madog/planb/README.md

# planb

Electrical and mechanical designs based on the Plan B powder printer (https://ytec3d.com/plan-b/)
