madog/planb/electronics/datasheets/C6602 pinout.txt

1  -> 20V
2  -> N08
3  -> N07
4  -> N06
5  -> N09
6  -> N10
7  -> N11
8  -> N12
9  -> N01
10 -> N02
11 -> N05
12 -> N04
13 -> N03
14 -> 20V
15 -> key
16 -> key
