madog/planb/mechanics/Parts List.xlsx

Sheet: Hardware
Part | PN | Manufacturer | Price | Qty | Subtotal | Ordered?
0.375x1.000 Steel Spring (x12) | 9657K306 | McMaster | $10.35 | 2 | $20.70 | Y
[624ZZ] 4x13 SS Ball Bearing |  | eBay | $0.66 | 25 | $16.48 | Y
[625ZZ] 5x16 SS Ball Bearing |  | eBay | $0.74 | 2 | $1.49 | Y
[LM8UU] 8x24 Linear Bearing | RJ4JP-01-08 | igus (eBay) | $2.29 | 12 | $27.43 | Y
M3 SS Nut (x100) | 91828A211 | McMaster | $5.55 | 1 | $5.55 | Y
M3 SS Washer (x100) | 93475A210 | McMaster | $1.62 | 2 | $3.24 | Y
M3x10 SS SHCS (x100) | 91292A113 | McMaster | $4.53 | 1 | $4.53 | Y
M3x12 SS Standoff | 93655A422 | McMaster | $4.03 | 4 | $16.12 | Y
M3x16 SS SHCS (x100) | 91292A115 | McMaster | $5.36 | 1 | $5.36 | Y
M4 SS Locknut (x100) | 93625A150 | McMaster | $5.62 | 3 | $16.86 | Y
M4 SS Nut (x100) | 91828A231 | McMaster | $6.45 | 1 | $6.45 | Y
M4 SS Washer (x100) | 93475A230 | McMaster | $1.86 | 5 | $9.30 | Y
M4x10 SS SHCS (x100) | 91292A116 | McMaster | $6.59 | 1 | $6.59 | Y
M4x12 SS SHCS (x100) | 91292A117 | McMaster | $6.59 | 1 | $6.59 | Y
M4x16 SS SHCS (x100) | 91292A118 | McMaster | $7.42 | 1 | $7.42 | Y
M4x20 SS SHCS (x100) | 91292A121 | McMaster | $8.42 | 1 | $8.42 | Y
M4x25 SS SHCS (x100) | 91292A122 | McMaster | $9.06 | 1 | $9.06 | Y
M4x25 SS Standoff FF | 94868A045 | McMaster | $4.39 | 8 | $35.12 | Y
M4x30 SS SHCS (x100) | 91292A130 | McMaster | $10.30 | 1 | $10.30 | Y
M4x30 SS Standoff FF | 94868A183 | McMaster | $3.26 | 4 | $13.04 | Y
M4x35 SS SHCS (x50) | 91292A131 | McMaster | $6.80 | 1 | $6.80 | Y
M4x40 SS FHSS (x50) | 92125A205 | McMaster | $9.60 | 1 | $9.60 | Y
M4x40 SS SHCS (x50) | 91292A132 | McMaster | $6.44 | 1 | $6.44 | Y
M4x50 SS SHCS (x25) | 91292A140 | McMaster | $5.46 | 1 | $5.46 | Y
M5 SS Fender Washer (x100) | 91116A140 | McMaster | $7.04 | 1 | $7.04 | Y
M6 SS Nut (x100) | 91828A251 | McMaster | $8.73 | 1 | $8.73 | Y
M6 SS Washer (x100) | 93475A250 | McMaster | $4.86 | 1 | $4.86 | Y
M8 SS Nut (x50) | 91828A410 | McMaster | $9.98 | 1 | $9.98 | Y
M4x500 SS Threaded Rod | 90024A222 | McMaster | $4.20 | 1 | $4.20 | Y
M6x200 SS Threaded Rod | 93805A640 | McMaster | $4.00 | 6 | $24.00 | Y
M8x150 SS Threaded Rod | 93805A641 | McMaster | $5.03 | 3 | $15.09 | Y
5x200 SS Rotary Shaft | 1265K44 | McMaster | $16.96 | 1 | $16.96 | Y
5x400 SS Rotary Shaft | 1265K46 | McMaster | $29.83 | 1 | $29.83 | Y
8x1000 SS Linear Shaft | 6459K115 | eBay | $18.00 | 4 | $72.00 | Y
16x500 2mm Wall SS Tube | 50365K35 | McMaster | $55.02 | 1 | $55.02 | Y
5mm shaft coupler |  | Amazon | $3.48 | 2 | $6.97 | Y
 |  |  |  | Total: | $506.05

Sheet: 3DP
Part Name | Qty | Volume (cm^3) | Volume subtotal | Material/Process | Rec'd?
Carriage Belt Clamp | 2 | 14.804 | 29.608 | ASA/FDM | Yes
Carriage Carrier | 1 | 24.798 | 24.798 | ASA/FDM | Yes
Carriage Cartridge Adapter | 1 | 1.369 | 1.369 | ASA/FDM | Yes
GUI Button | 8 | 0.381 | 3.048 | Nylon/SLS | Yes
GUI Corner Holder | 2 | 13.702 | 27.404 | Nylon/SLS | Yes
GUI Face | 1 | 88.796 | 88.796 | Nylon/SLS | Yes
GUI Rotary | 1 | 3.641 | 3.641 | Nylon/SLS | Yes
Hopper Idler | 1 | 28.926 | 28.926 | ASA/FDM | Yes
Hopper Idler (mirrored) | 1 | 28.926 | 28.926 | ASA/FDM | Yes
Hopper Linear Bearing Holder | 6 | 30.644 | 183.864 | ASA/FDM | Yes
Hopper Motor Holder | 1 | 40.381 | 40.381 | ASA/FDM | Yes
Hopper Nut Trap | 3 | 9.951 | 29.853 | ASA/FDM | Yes
Hopper Nut Trap Holder | 3 | 3.947 | 11.841 | ASA/FDM | Yes
Hopper Rod Clamp | 1 | 34.831 | 34.831 | ASA/FDM | Yes
Hopper Smooth Rod Clamp | 12 | 1.748 | 20.976 | ASA/FDM | Yes
Piston Driver Clamp | 6 | 4.301 | 25.806 | ASA/FDM | Yes
Piston Flag | 3 | 0.246 | 0.738 | Nylon/SLS | Yes
Piston Flag Holder | 3 | 1.861 | 5.583 | ASA/FDM | Yes
Piston Guide Holder | 12 | 11.831 | 141.972 | ASA/FDM | Yes
Piston Nut Trap | 12 | 0.577 | 6.924 | ASA/FDM | Yes
Piston Wall Guide | 6 | 7.048 | 42.288 | ASA/FDM | Yes
Piston Wall Guide Small | 4 | 1.713 | 6.852 | ASA/FDM | Yes
Piston Wall Guide Wide | 4 | 3.694 | 14.776 | ASA/FDM | Yes
Spreader Belt Clamp | 2 | 1.113 | 2.226 | ASA/FDM | Yes
Spreader Flag | 1 | 0.550 | 0.55 | Nylon/SLS | Yes
Spreader Frame | 2 | 9.221 | 18.442 | ASA/FDM | Yes
Spreader Holder | 2 | 2.815 | 5.63 | ASA/FDM | Yes
Spreader Linear Bearing Clamp | 2 | 11.361 | 22.722 | ASA/FDM | Yes
X-axis Driver Holder | 1 | 22.917 | 22.917 | ASA/FDM | Yes
X-axis Holder Coupler | 8 | 4.175 | 33.4 | ASA/FDM | Yes
X-axis Idler | 2 | 10.207 | 20.414 | ASA/FDM | Yes
X-axis Motor Holder | 1 | 25.435 | 25.435 | ASA/FDM | Yes
X-axis Rod Holder | 6 | 1.668 | 10.008 | ASA/FDM | Yes
X-axis Y Idler | 1 | 6.938 | 6.938 | ASA/FDM | Yes
X-axis Y Motor Holder | 1 | 11.888 | 11.888 | ASA/FDM | Yes
Y-axis Belt Clamp | 4 | 0.797 | 3.188 | ASA/FDM | Yes
Y-axis Belt Idler 1 | 1 | 4.276 | 4.276 | ASA/FDM | No
Y-axis Belt Idler 2 | 1 | 4.276 | 4.276 | ASA/FDM | No
Y-axis Belt Return | 1 | 3.812 | 3.812 | ASA/FDM | Yes
Y-axis Carriage Flag | 1 | 0.670 | 0.67 | Nylon/SLS | Yes
Y-axis Frame Block | 2 | 30.438 | 60.876 | ASA/FDM | Yes
Y-axis Linear Bearing Clamp | 2 | 2.401 | 4.802 | ASA/FDM | Yes
Y-axis X-axis flag | 1 | 0.802 | 0.802 | Nylon/SLS | Yes
Totals | 136 |  | 1066.473
