madog/planb/electronics/bom/master_v1.xlsx

Mouser P/N | Description | Price | Qty | Subtotal | Board Qtys
80-C1206C475K3R | Multilayer Ceramic Capacitors MLCC - SMD/SMT 25volts 4.7uF X7R 10% | $0.34 | 10 | $3.40 | BD | 5
80-C1206C106K3R | Multilayer Ceramic Capacitors MLCC - SMD/SMT 10uF 25 Volts 10% X7R | $0.69 | 10 | $6.90 | FFC | 5
80-C1206C105K3R | Multilayer Ceramic Capacitors MLCC - SMD/SMT 25volts 1uF X7R 10% | $0.22 | 5 | $1.10
80-C1206C104K3R | Multilayer Ceramic Capacitors MLCC - SMD/SMT 25volts 0.1uF X7R 10% | $0.12 | 15 | $1.80 | Total | $104.99
80-C1206C103K3R | Multilayer Ceramic Capacitors MLCC - SMD/SMT 25volts 10000pF X7R 10% | $0.28 | 5 | $1.40
80-C1206C223K3R | Multilayer Ceramic Capacitors MLCC - SMD/SMT 25volts 22000pF X7R 10% | $0.32 | 5 | $1.60
80-C0805C182K5R | Multilayer Ceramic Capacitors MLCC - SMD/SMT 50volts 1800pF X7R 10% | $0.23 | 5 | $1.15
80-C0805C273K5R | Multilayer Ceramic Capacitors MLCC - SMD/SMT 50volts 27000pF X7R 10% | $0.11 | 5 | $0.55
512-FSV8100V | Schottky Diodes & Rectifiers 8 Amp 100V Schottky Rectifier | $0.63 | 10 | $6.30
604-WP1543SGC | Standard LEDs - Through Hole GREEN WATER CLEAR | $0.21 | 15 | $3.15
604-WP1543SRC/C | Standard LEDs - Through Hole RED WATER CLEAR | $0.31 | 5 | $1.55
81-FDVE1040-H-4R7MP3 | Fixed Inductors 4.7uH 13.8mOhms 8.2A +/-20% | $1.52 | 5 | $7.60
512-FDD4141 | MOSFET -40V P-Channel PowerTrench | $1.05 | 5 | $5.25
71-CRCW1206-47K-E3 | Thick Film Resistors 1/4watt 47Kohms 1% | $0.10 | 5 | $0.50
71-CRCW1206J-1K-E3 | Thick Film Resistors 1/4watt 1Kohms 5% | $0.02 | 20 | $0.44
71-CRCW120610K0JNEB | Thick Film Resistors - SMD 1/4watt 10Kohms 5% | $0.10 | 10 | $1.00
71-CRCW1206470RJNEB | Thick Film Resistors 1/4watt 470ohms 5% | $0.10 | 5 | $0.50
71-CRCW0805-1.37K-E3 | Thick Film Resistors 1/8watt 1.37Kohms 1% 100ppm | $0.10 | 5 | $0.50
71-CRCW0805154KFKEA | Thick Film Resistors 1/8watt 154Kohms 1% 100ppm | $0.10 | 5 | $0.50
71-CRCW080510K0DHEAP | Thick Film Resistors 1/8W 10kOhm .5% | $0.27 | 5 | $1.35
595-TPS55330RTER | Switching Voltage Regulators 5A 24V Wide In Range DC-DC Reg | $3.09 | 5 | $15.45
595-CD74HC4067M96 | Multiplexer Switch ICs Hi-Spd CMOS 16Ch Anl Mltplxr/Demltplxr | $0.78 | 5 | $3.90
595-ULN2803ADWR | Darlington Transistors TRANSISTOR ARRAYS | $1.41 | 10 | $14.10
630-ACPL-217-50BE | Transistor Output Optocouplers 3000Vrms 50% CTR | $0.60 | 5 | $3.00
571-282834-2 | Fixed Terminal Blocks 2P SIDE ENTRY 2.54mm | $0.52 | 5 | $2.60
649-68015-402HLF | Headers & Wire Housings 2P SR UNSHRD HRD TIN OVER NI | $0.18 | 5 | $0.90
538-90121-0763 | Headers & Wire Housings 2.54MM CGRIDIII HDR 3P R/A SR SEL AU | $0.75 | 10 | $7.50
649-68021-408HLF | Headers & Wire Housings 8P SR UNSHRD HRD TIN OVER NI | $0.47 | 5 | $2.35
649-77313-418-16LF | Headers & Wire Housings 16P STR DR TMT HDR TIN .45IN LENGTH | $0.50 | 10 | $5.00
649-SFW16R-2STE1LF | FFC & FPC Connectors 16P SIDE SMT ZIF UPPER CONTACT | $0.73 | 5 | $3.65
