madog/planb/mechanics/Electronics/Omron PEC12R-4x20F-Xxxxx.stp

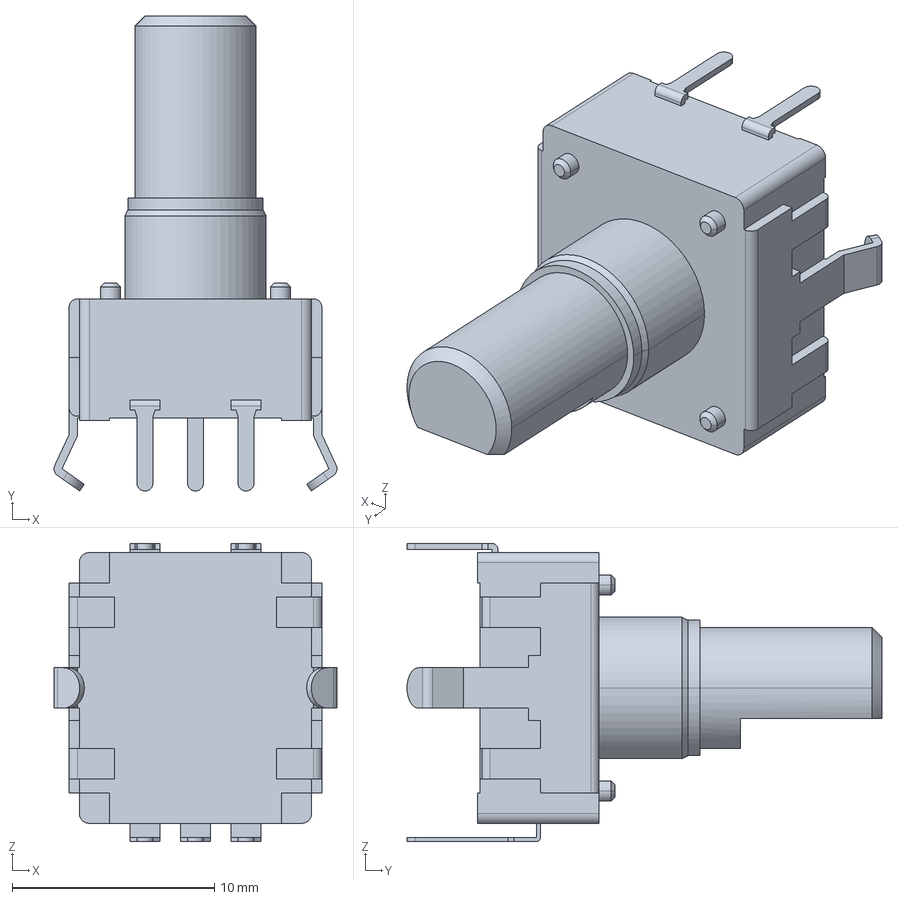
[picture p1: CAD file, 2018-04-14]
mechanics/Electronics/Omron PEC12R-4x20F-Xxxxx.stp
14.0 x 23.5 x 14.7 mm
