madog/planb/mechanics/STLs/Y-axis Belt Idler.stl

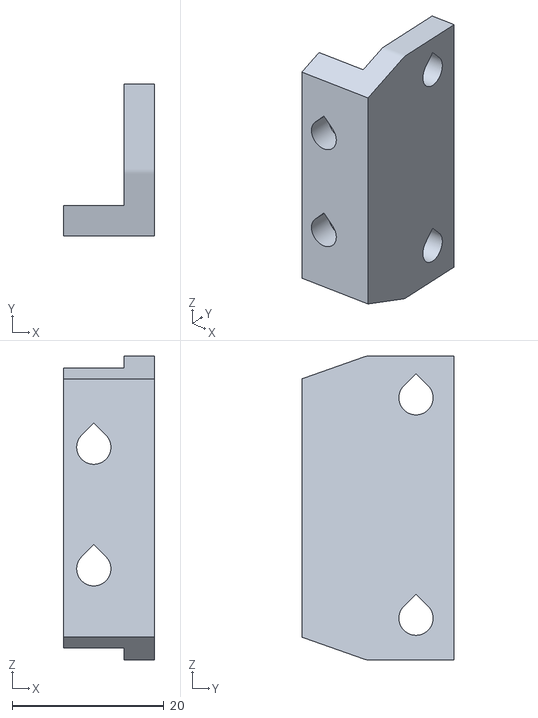
[picture p2: CAD file, 2017-12-08]
mechanics/STLs/Y-axis Belt Idler.stl
12.0 x 20.0 x 40.0
