madog/planb/mechanics/Electronics/NHD-0420CW.stp

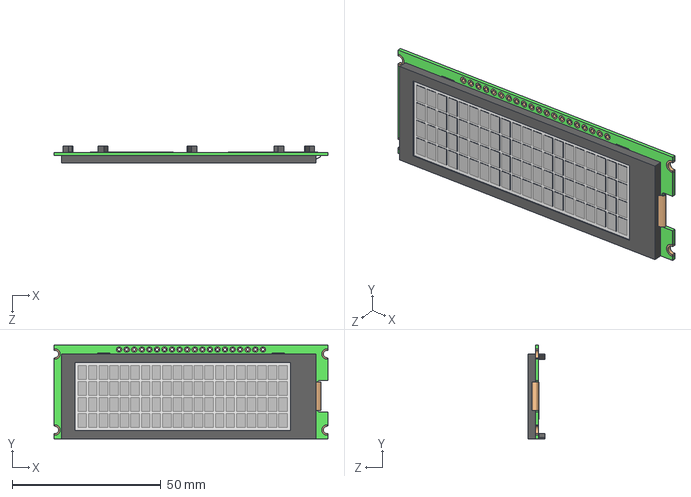
[picture p3: CAD file, 2018-04-14]
mechanics/Electronics/NHD-0420CW.stp
92.0 x 31.5 x 5.60 mm
