madog/planb/mechanics/STLs/Spreader Holder.stl

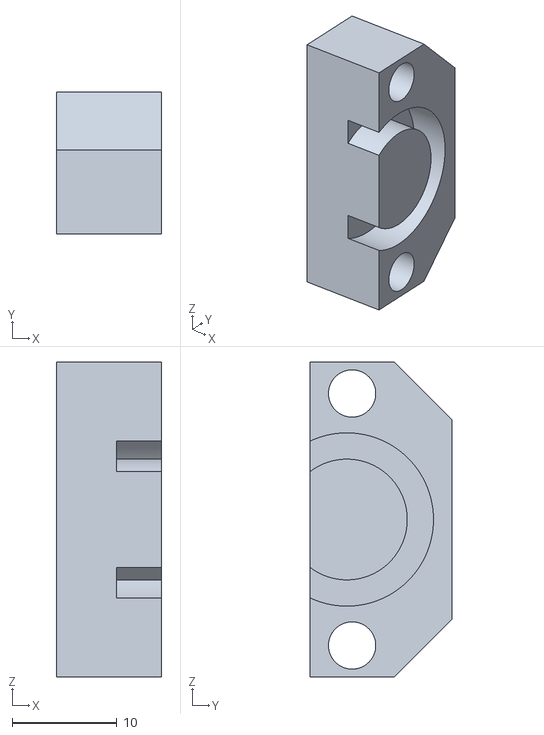
[picture p4: CAD file, 2017-12-08]
mechanics/STLs/Spreader Holder.stl
10.0 x 13.5 x 30.0
