madog/planb/mechanics/STLs/Carriage Belt Clamp.stl

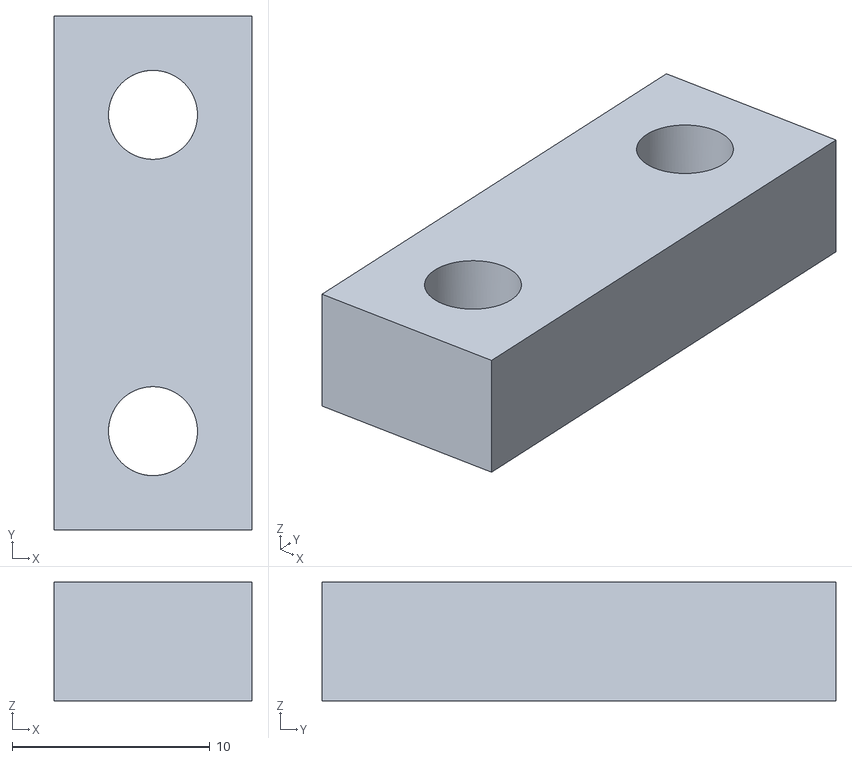
[picture p5: CAD file, 2017-10-05]
mechanics/STLs/Carriage Belt Clamp.stl
10.0 x 26.0 x 6.00
