madog/planb/mechanics/STLs/Y-axis Belt Clamp.stl

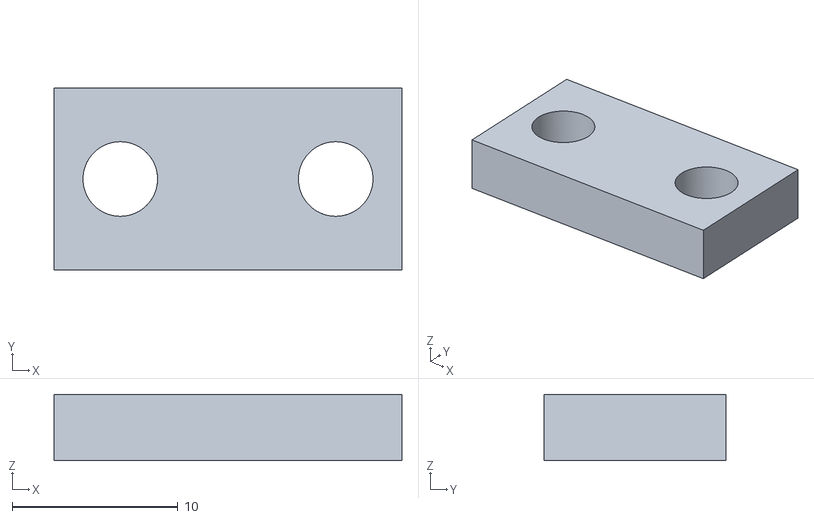
[picture p6: CAD file, 2017-10-05]
mechanics/STLs/Y-axis Belt Clamp.stl
21.0 x 11.0 x 4.00
