madog/planb/mechanics/STLs/Y-axis X-axis Flag.stl

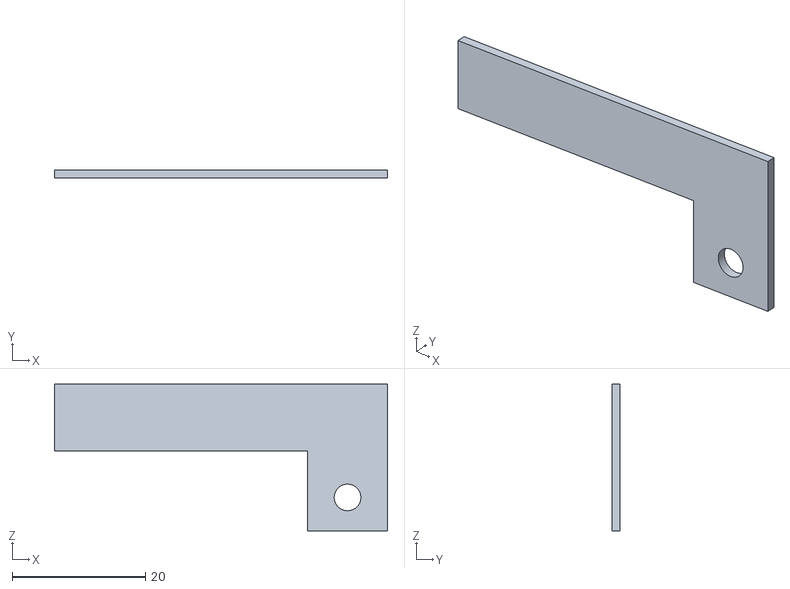
[picture p7: CAD file, 2017-10-05]
mechanics/STLs/Y-axis X-axis Flag.stl
50.0 x 1.27 x 22.0
