madog/planb/mechanics/STLs/Piston Guide Holder.stl

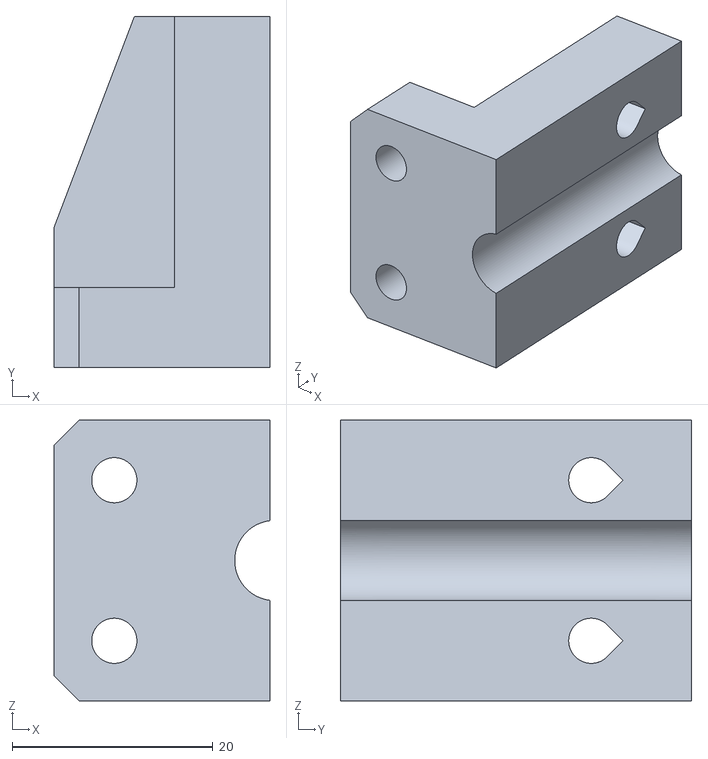
[picture p8: CAD file, 2017-10-05]
mechanics/STLs/Piston Guide Holder.stl
21.5 x 35.0 x 28.0
