madog/planb/mechanics/STLs/Spreader Belt Clamp.stl

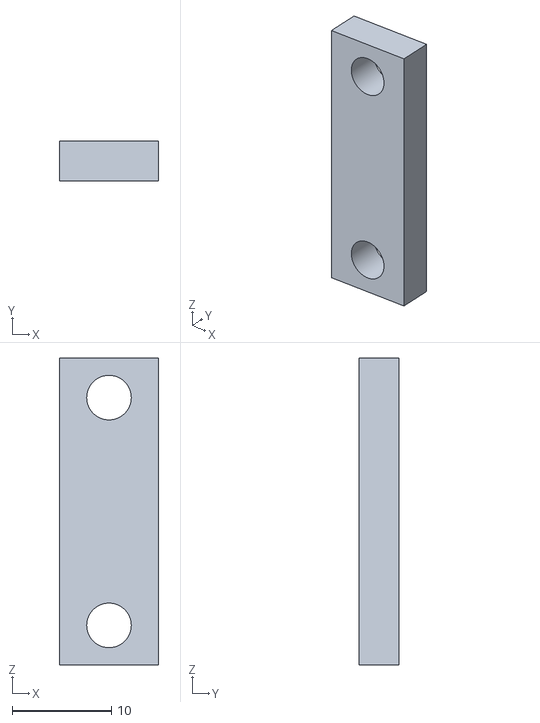
[picture p9: CAD file, 2017-10-05]
mechanics/STLs/Spreader Belt Clamp.stl
10.0 x 4.00 x 31.0
