madog/planb/mechanics/STLs/Spreader Frame.stl

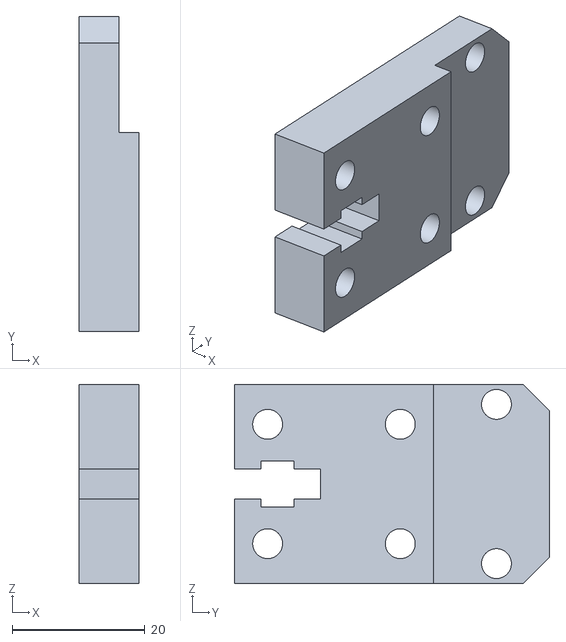
[picture p10: CAD file, 2017-10-05]
mechanics/STLs/Spreader Frame.stl
9.00 x 47.5 x 30.0
