madog/planb/mechanics/STLs/Hopper Idler.stl

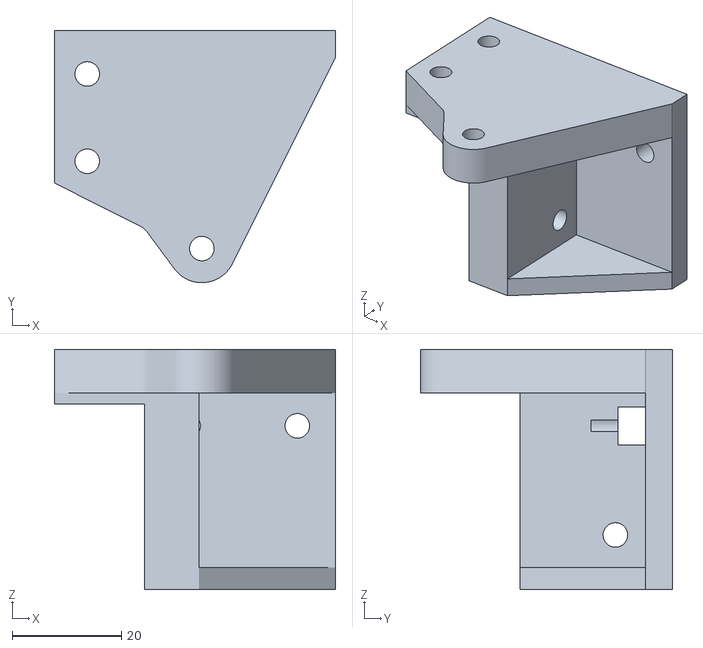
[picture p11: CAD file, 2017-10-05]
mechanics/STLs/Hopper Idler.stl
51.5 x 46.2 x 44.0
