madog/planb/mechanics/STLs/Piston Wall Guide.stl

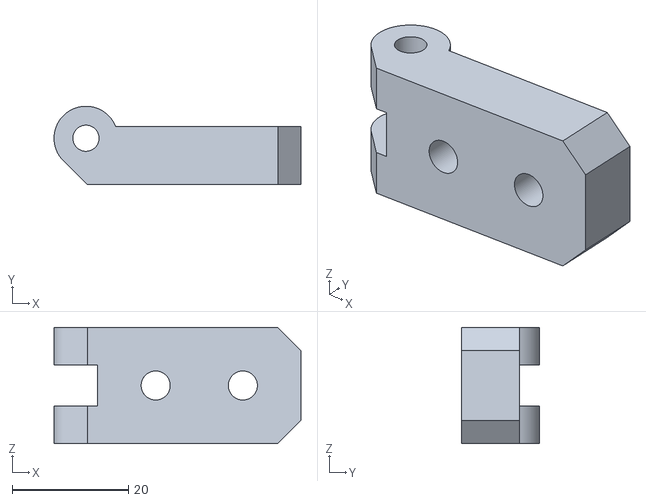
[picture p12: CAD file, 2017-10-05]
mechanics/STLs/Piston Wall Guide.stl
42.5 x 13.5 x 20.0
