madog/planb/mechanics/STLs/X-axis Y Motor Holder.stl

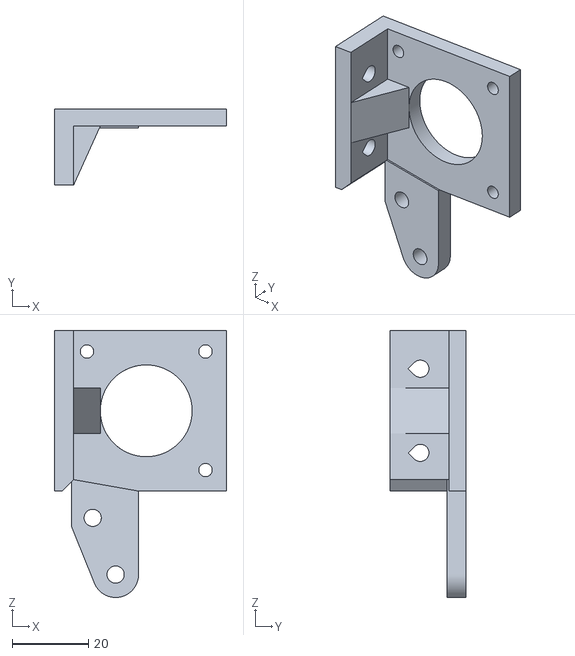
[picture p13: CAD file, 2017-10-05]
mechanics/STLs/X-axis Y Motor Holder.stl
45.0 x 20.0 x 69.8
