madog/planb/mechanics/STLs/GUI Corner Holder.stl

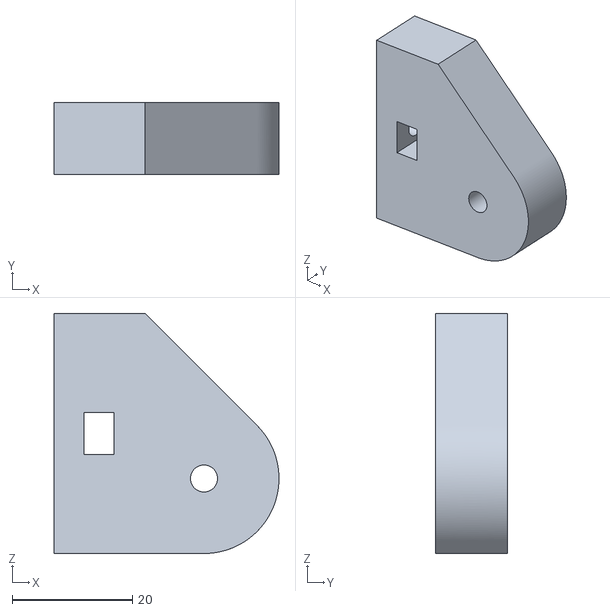
[picture p14: CAD file, 2017-10-05]
mechanics/STLs/GUI Corner Holder.stl
37.5 x 12.0 x 40.0
