madog/planb/mechanics/STLs/Hopper Smooth Rod Clamp.stl

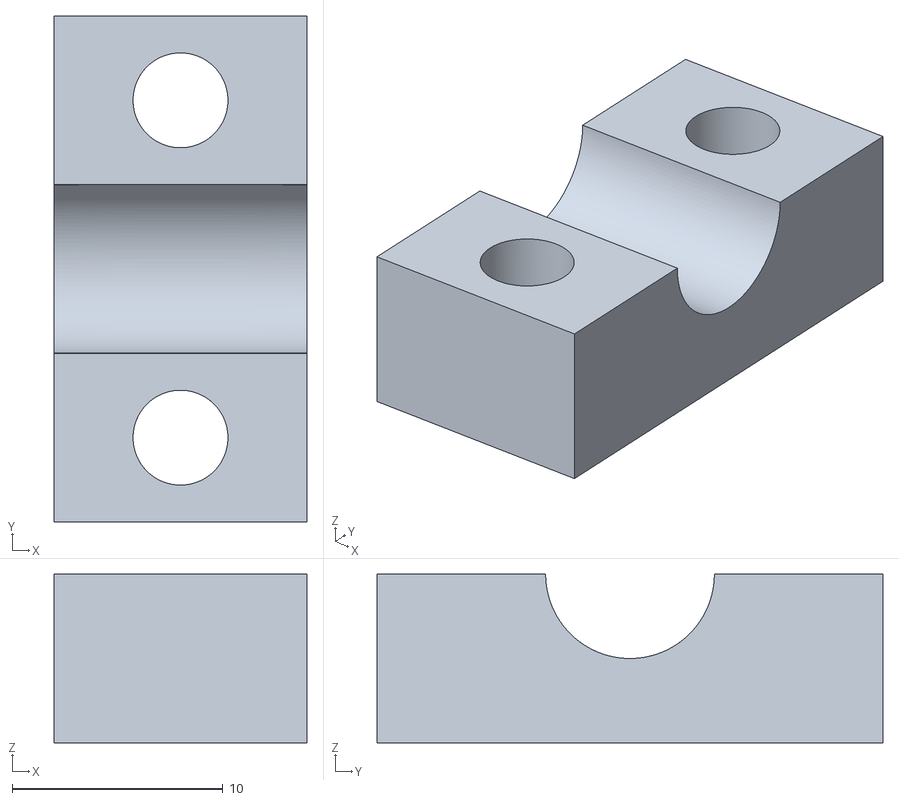
[picture p15: CAD file, 2017-10-05]
mechanics/STLs/Hopper Smooth Rod Clamp.stl
12.0 x 24.0 x 8.00
