madog/planb/mechanics/STLs/Y-axis Belt Return.stl

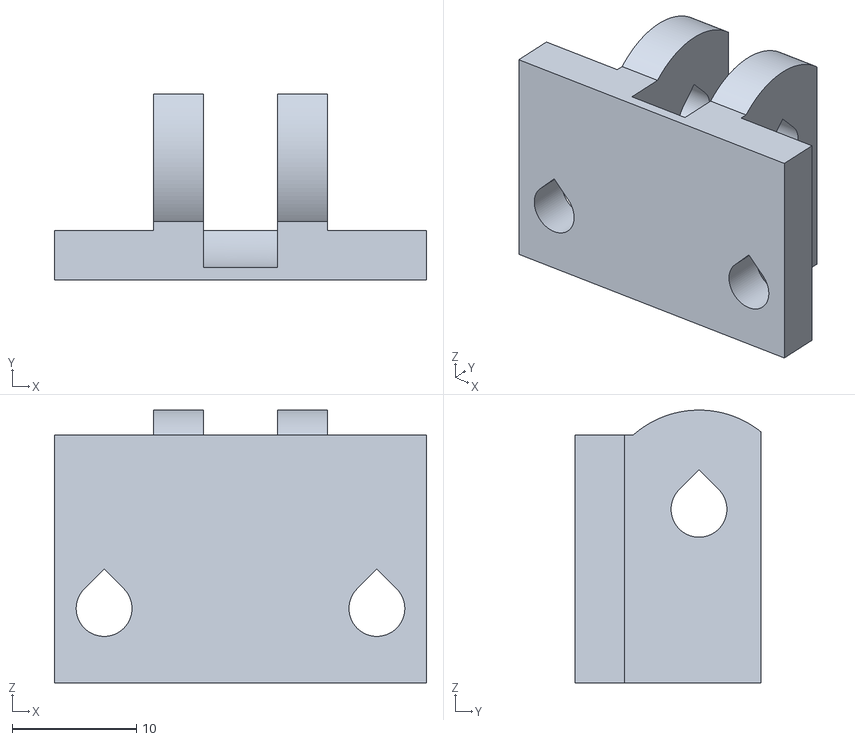
[picture p16: CAD file, 2017-10-05]
mechanics/STLs/Y-axis Belt Return.stl
30.0 x 15.0 x 22.0
