madog/planb/mechanics/STLs/X-axis Holder Coupler.stl

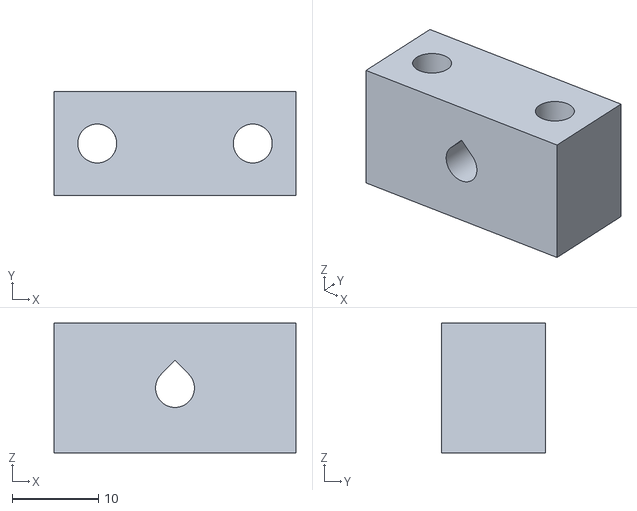
[picture p17: CAD file, 2017-10-05]
mechanics/STLs/X-axis Holder Coupler.stl
28.0 x 12.0 x 15.0
