madog/planb/mechanics/STLs/Carriage Carrier.stl

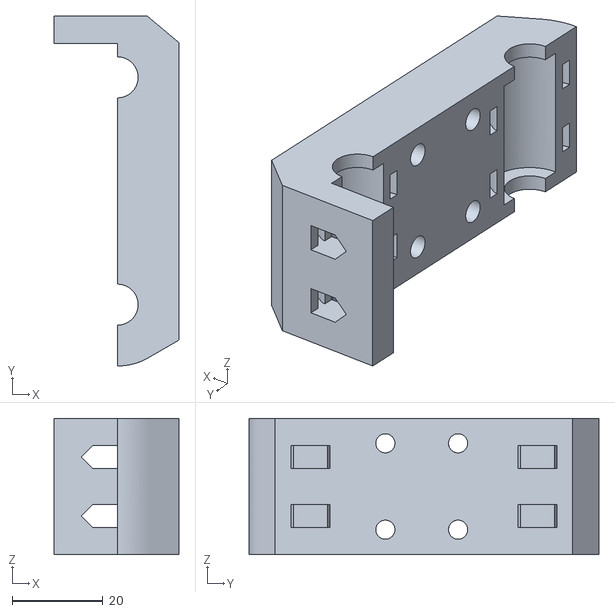
[picture p18: CAD file, 2017-10-05]
mechanics/STLs/Carriage Carrier.stl
27.5 x 77.0 x 30.0
