madog/planb/mechanics/STLs/Carriage Cartridge Adapter.stl

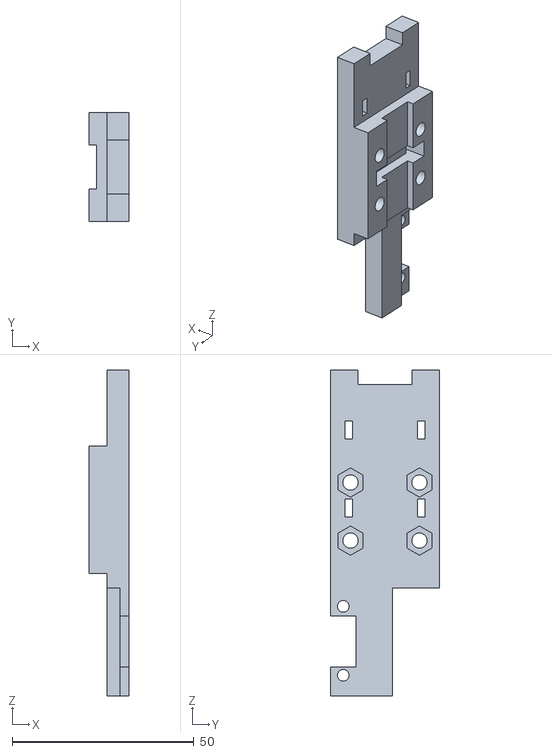
[picture p19: CAD file, 2017-10-05]
mechanics/STLs/Carriage Cartridge Adapter.stl
11.0 x 30.0 x 89.8
