madog/planb/mechanics/STLs/Hopper Rod Clamp.stl

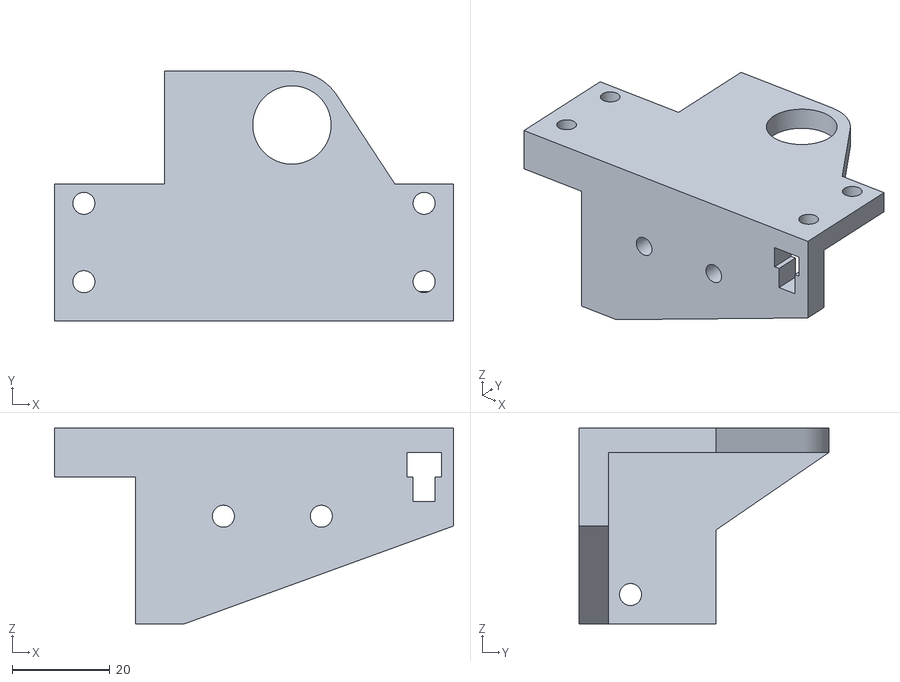
[picture p20: CAD file, 2017-10-05]
mechanics/STLs/Hopper Rod Clamp.stl
81.5 x 51.0 x 40.0
