madog/planb/mechanics/STLs/X-axis Y Idler.stl

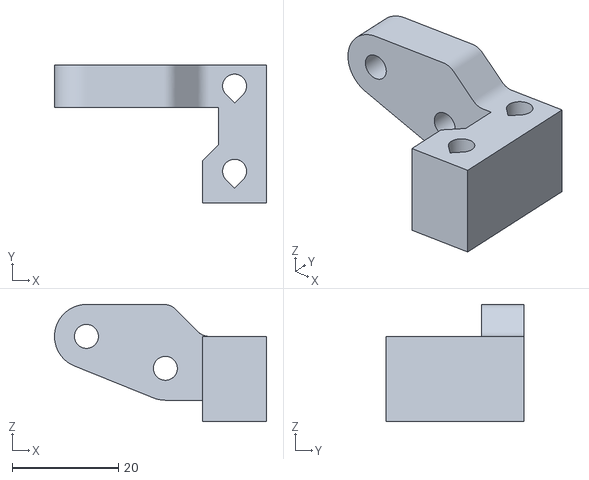
[picture p21: CAD file, 2017-10-05]
mechanics/STLs/X-axis Y Idler.stl
39.8 x 26.0 x 22.0
