madog/planb/mechanics/STLs/X-axis Driver Holder.stl

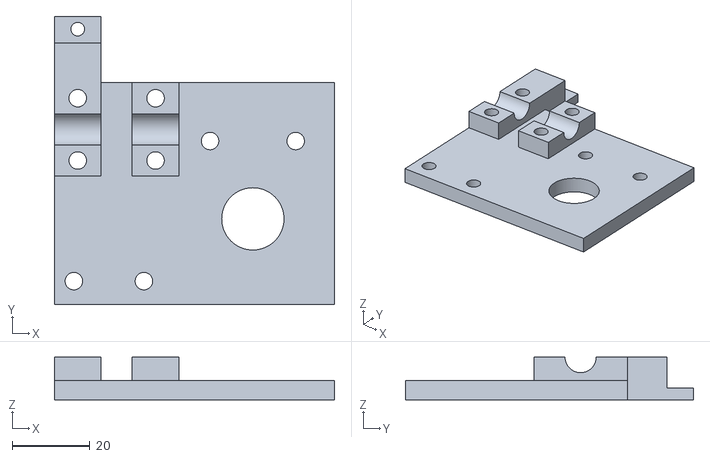
[picture p22: CAD file, 2017-10-05]
mechanics/STLs/X-axis Driver Holder.stl
72.0 x 74.0 x 11.0
