madog/planb/mechanics/STLs/X-axis Rod Holder.stl

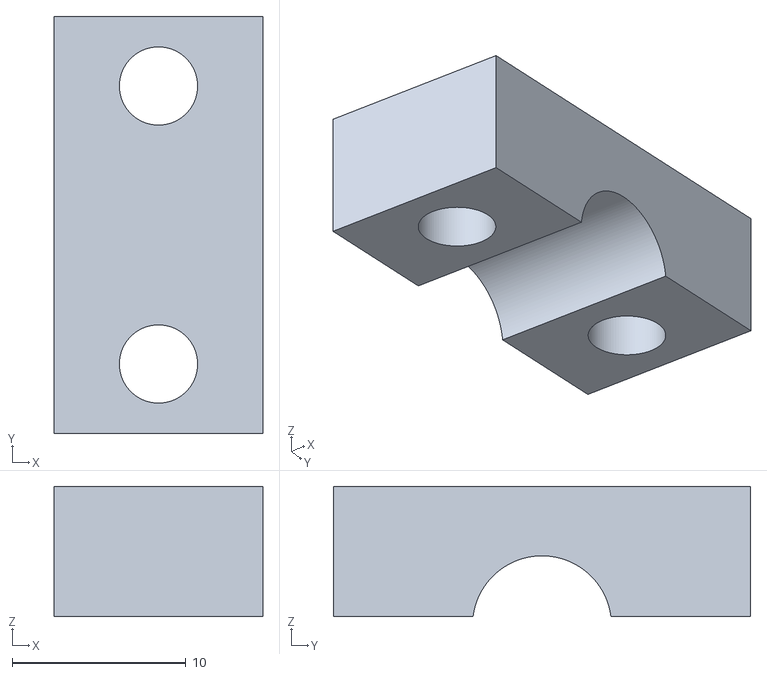
[picture p23: CAD file, 2017-10-05]
mechanics/STLs/X-axis Rod Holder.stl
12.0 x 24.0 x 7.50
