madog/planb/mechanics/STLs/Y-axis Linear Bearing Clamp.stl

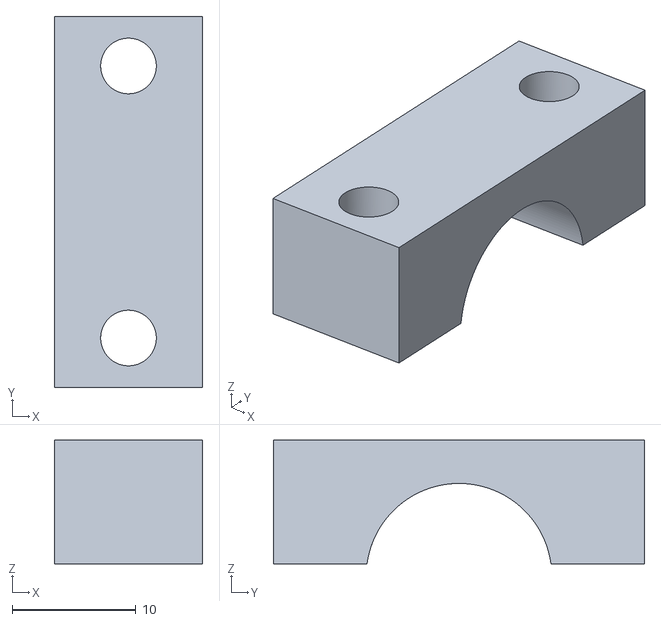
[picture p24: CAD file, 2017-10-05]
mechanics/STLs/Y-axis Linear Bearing Clamp.stl
12.0 x 30.0 x 10.0
