madog/planb/mechanics/STLs/Y-axis Carriage Flag.stl

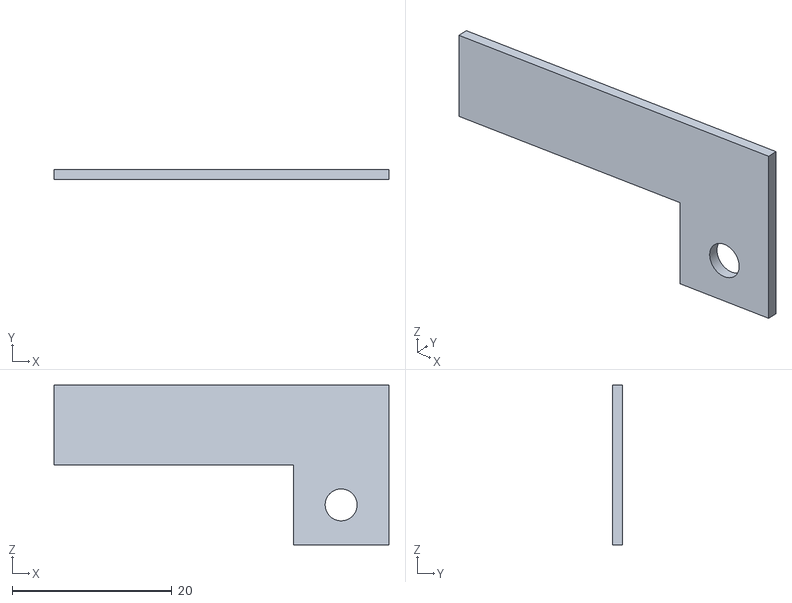
[picture p25: CAD file, 2017-10-05]
mechanics/STLs/Y-axis Carriage Flag.stl
42.0 x 1.27 x 20.0
