madog/planb/mechanics/STLs/GUI Rotary.stl

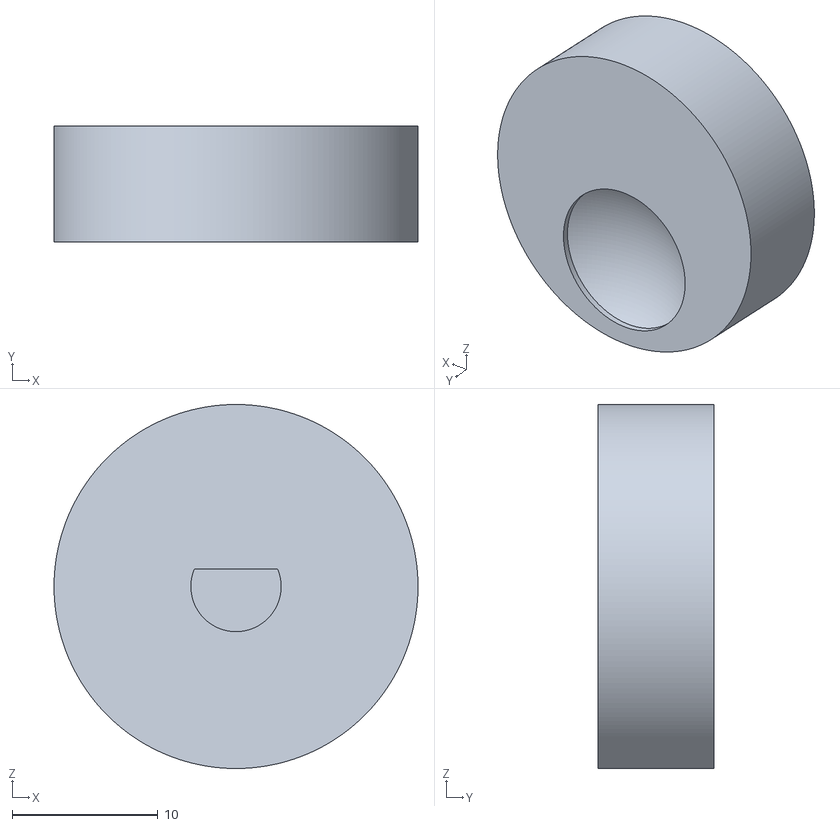
[picture p26: CAD file, 2017-10-05]
mechanics/STLs/GUI Rotary.stl
25.0 x 8.00 x 25.0
