madog/planb/mechanics/STLs/Y-axis Frame Block.stl

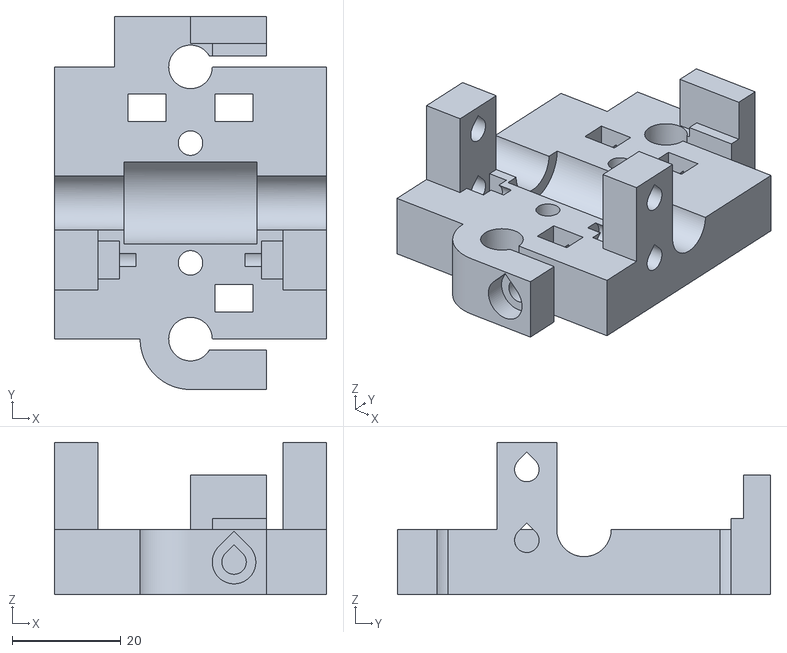
[picture p27: CAD file, 2017-10-05]
mechanics/STLs/Y-axis Frame Block.stl
50.0 x 68.5 x 28.0
