madog/planb/mechanics/STLs/GUI Face.stl

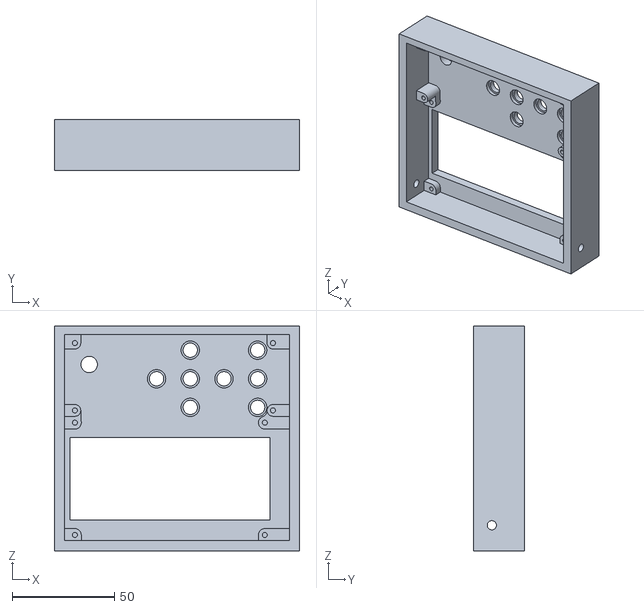
[picture p28: CAD file, 2017-10-05]
mechanics/STLs/GUI Face.stl
120.0 x 25.0 x 110.0
