madog/planb/mechanics/STLs/Spreader Linear Bearing Clamp.stl

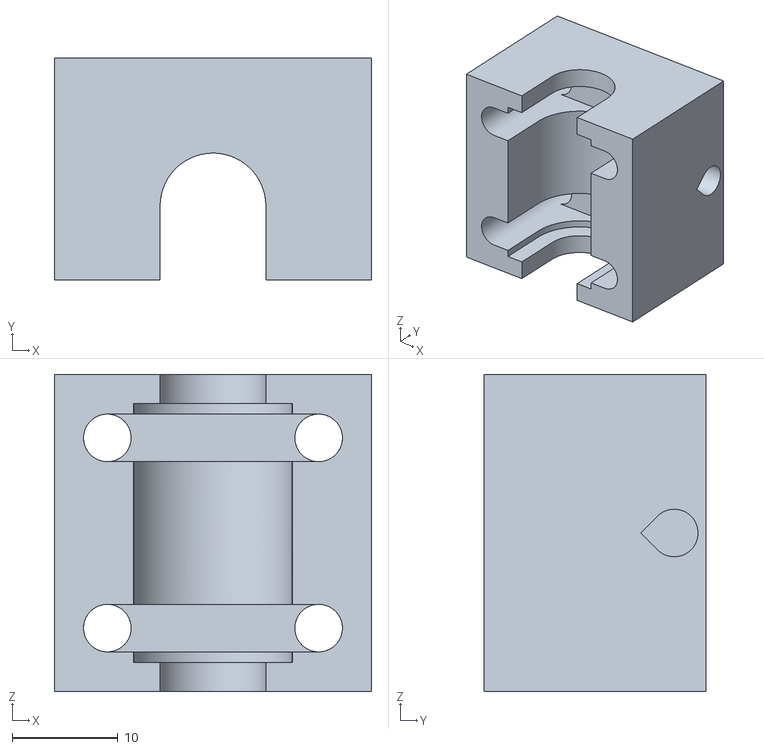
[picture p29: CAD file, 2017-10-05]
mechanics/STLs/Spreader Linear Bearing Clamp.stl
30.0 x 21.0 x 30.0
