madog/planb/mechanics/STLs/Spreader Flag.stl

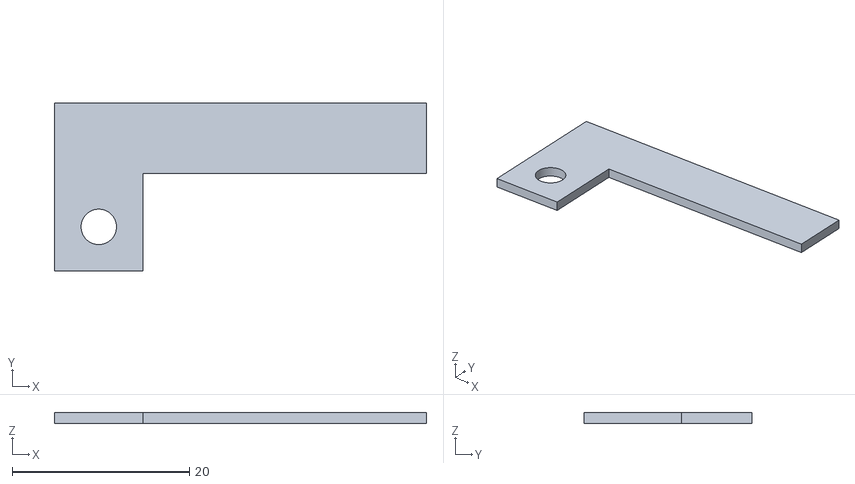
[picture p30: CAD file, 2017-10-05]
mechanics/STLs/Spreader Flag.stl
42.0 x 19.0 x 1.27
