madog/planb/mechanics/STLs/Piston Wall Guide Wide.stl

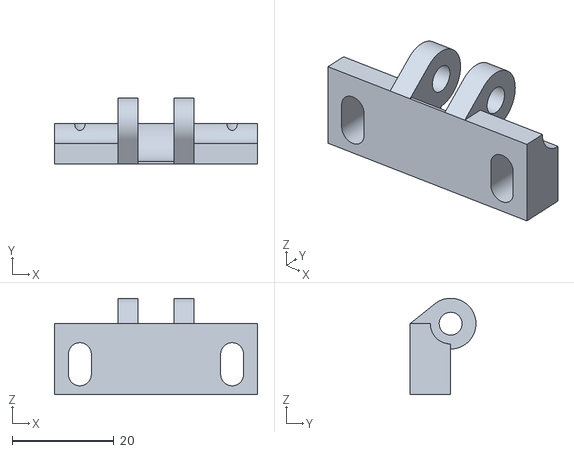
[picture p31: CAD file, 2017-10-05]
mechanics/STLs/Piston Wall Guide Wide.stl
40.0 x 13.0 x 19.0
