madog/planb/mechanics/STLs/GUI Button.stl

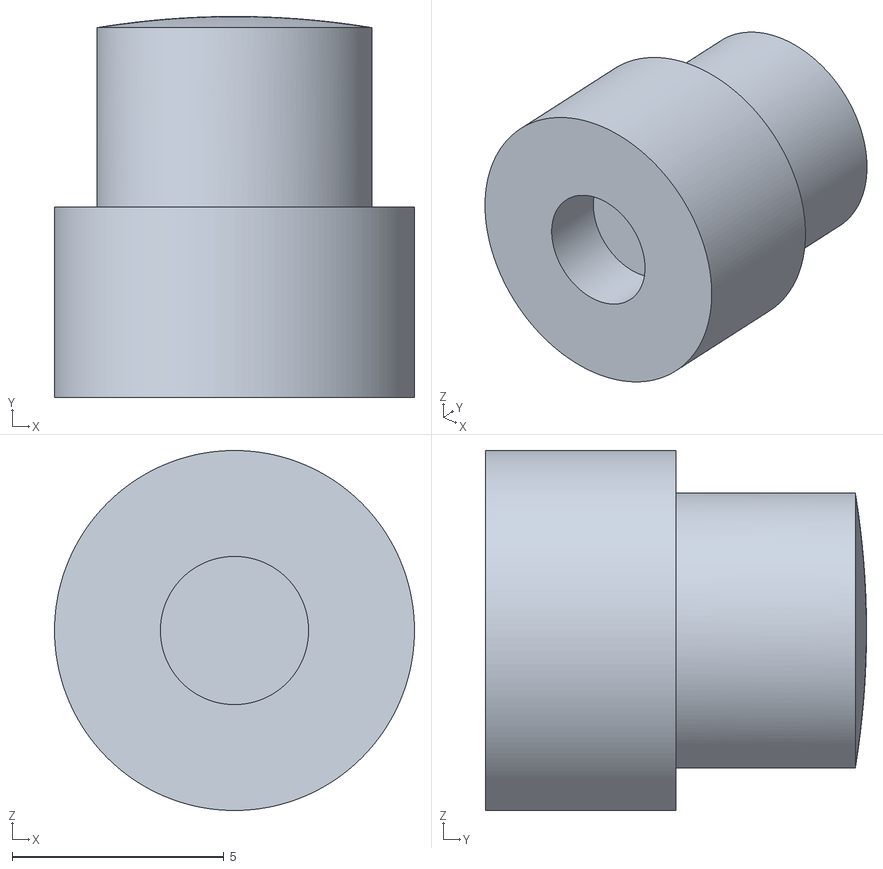
[picture p32: CAD file, 2017-10-05]
mechanics/STLs/GUI Button.stl
8.50 x 9.00 x 8.50
