madog/planb/mechanics/STLs/Piston Flag.stl

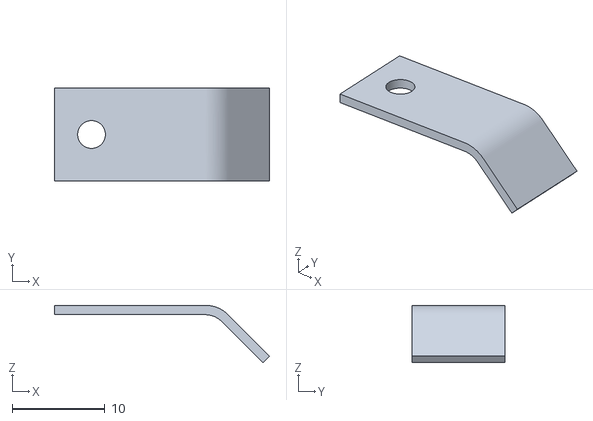
[picture p33: CAD file, 2017-10-05]
mechanics/STLs/Piston Flag.stl
23.2 x 10.0 x 6.20
