madog/planb/mechanics/STLs/X-axis Idler.stl

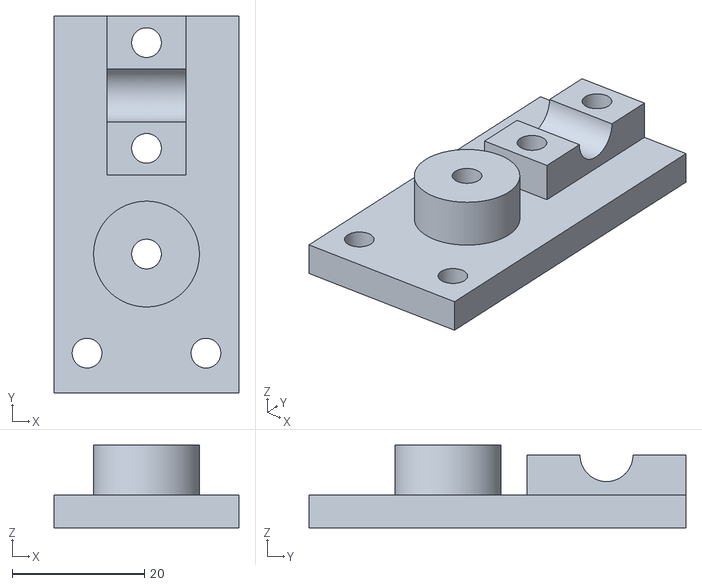
[picture p34: CAD file, 2017-10-05]
mechanics/STLs/X-axis Idler.stl
28.0 x 57.0 x 12.5
