madog/planb/mechanics/STLs/Piston Driver Clamp.stl

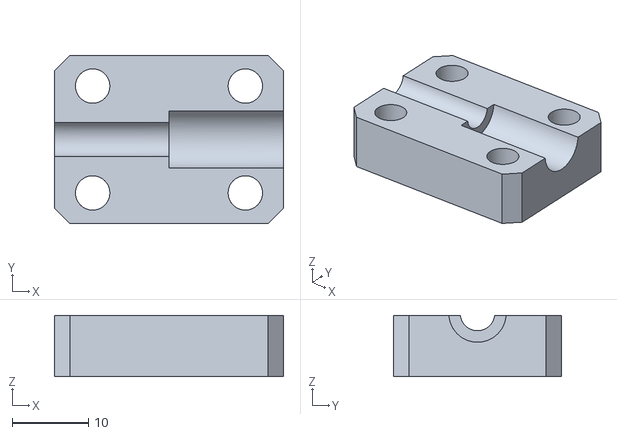
[picture p35: CAD file, 2017-10-05]
mechanics/STLs/Piston Driver Clamp.stl
30.0 x 22.0 x 8.00
