madog/planb/mechanics/STLs/Hopper Motor Holder.stl

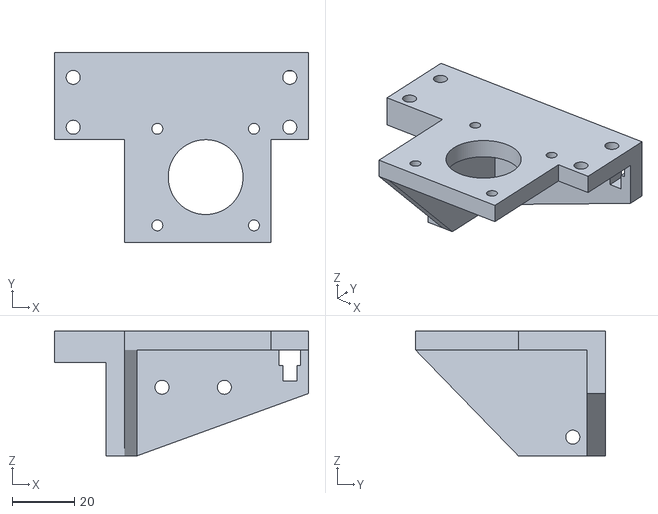
[picture p36: CAD file, 2017-10-05]
mechanics/STLs/Hopper Motor Holder.stl
81.5 x 61.0 x 40.0
