madog/planb/mechanics/STLs/Piston Flag Holder.stl

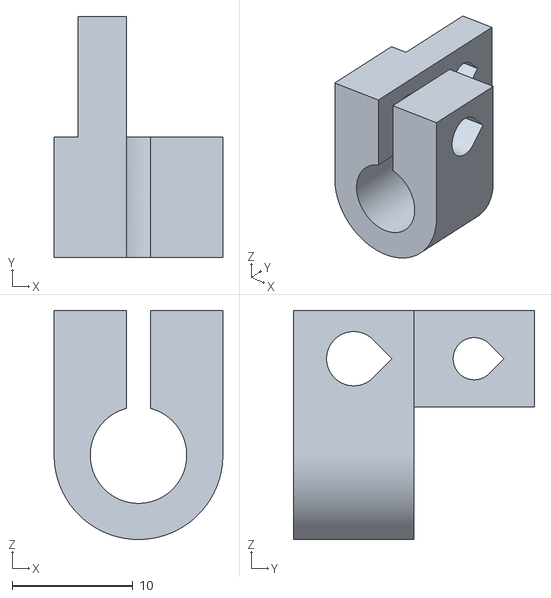
[picture p37: CAD file, 2017-10-05]
mechanics/STLs/Piston Flag Holder.stl
14.0 x 20.0 x 19.0
