madog/planb/mechanics/STLs/X-axis Motor Holder.stl

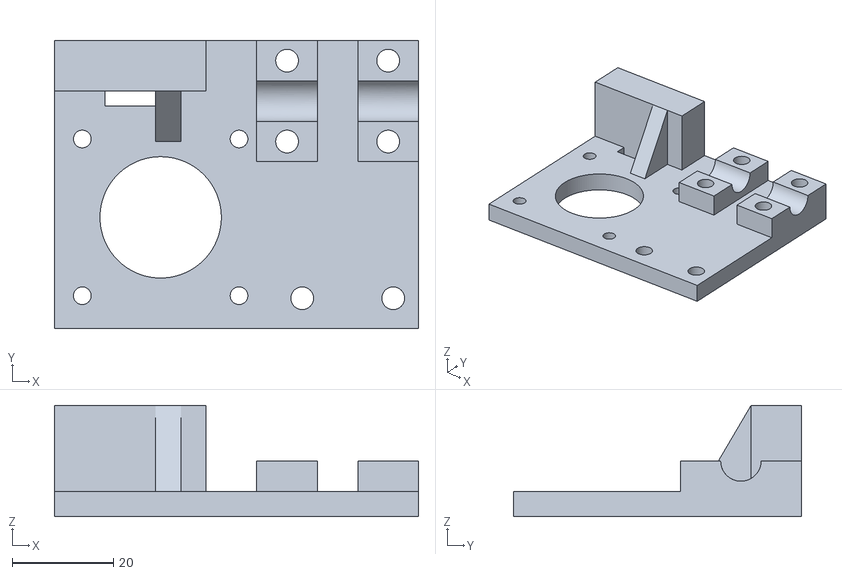
[picture p38: CAD file, 2017-10-05]
mechanics/STLs/X-axis Motor Holder.stl
72.0 x 57.0 x 22.0
