madog/planb/mechanics/STLs/Piston Wall Guide Small.stl

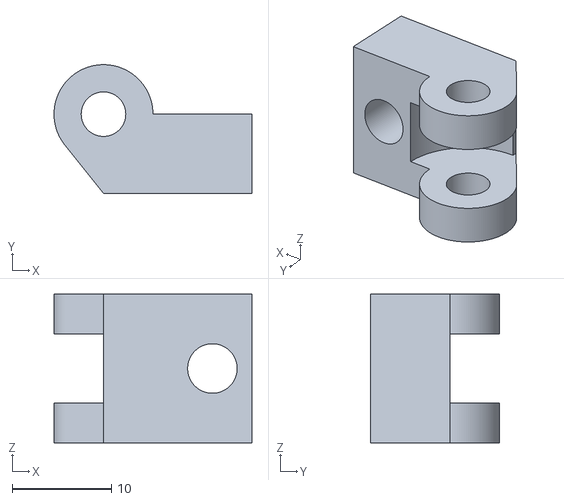
[picture p39: CAD file, 2017-10-05]
mechanics/STLs/Piston Wall Guide Small.stl
20.0 x 13.0 x 15.0
