madog/planb/mechanics/STLs/Hopper Linear Bearing Holder.stl

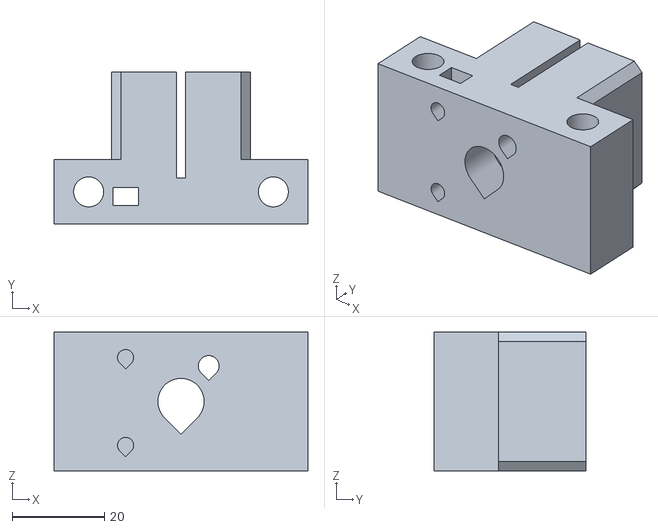
[picture p40: CAD file, 2017-10-05]
mechanics/STLs/Hopper Linear Bearing Holder.stl
55.0 x 33.0 x 30.0
