madog/planb/(list of files, cad)

Other CAD files:
mechanics/STLs/Hopper Idler (mirrored).stl
mechanics/Carriage/Carriage Belt Clamp.ipt
mechanics/Carriage/Carriage Carrier.ipt
mechanics/Carriage/Carriage Cartridge Adapter.ipt
mechanics/Controls/GUI Button.ipt
mechanics/Controls/GUI Corner Holder.ipt
mechanics/Controls/GUI Face.ipt
mechanics/Controls/GUI Rotary.ipt
mechanics/Controls/Interface Frame.ipt
mechanics/Drawings/Sheet metal.idw
mechanics/Electronics/4x20 LCD.ipt
mechanics/Electronics/C6602A.ipt
mechanics/Electronics/Cartridge Carrier.ipt
mechanics/Electronics/Endstop.ipt
mechanics/Electronics/Keypad.ipt
mechanics/Electronics/Megatronics/0402CAP_CAP0402CAP.ipt
mechanics/Electronics/Megatronics/0402RES_RESISTOR0402RES.ipt
mechanics/Electronics/Megatronics/0805_RESISTOR.ipt
mechanics/Electronics/Megatronics/1206_CAP1206.ipt
mechanics/Electronics/Megatronics/1x1- 2,54 Pitch.iam
mechanics/Electronics/Megatronics/2x1- 2,54 Pitch.iam
mechanics/Electronics/Megatronics/3M 9612xx-5604-AR Body.ipt
mechanics/Electronics/Megatronics/3M 9612xx-5604-AR Pin1.ipt
mechanics/Electronics/Megatronics/3M 9612xx-5604-AR Pin2.ipt
mechanics/Electronics/Megatronics/3M AR Body.ipt
mechanics/Electronics/Megatronics/3x1- 2,54 Pitch.iam
mechanics/Electronics/Megatronics/Circuito.ipt
mechanics/Electronics/Megatronics/Condensatore1.ipt
mechanics/Electronics/Megatronics/Condensatore2.ipt
mechanics/Electronics/Megatronics/Heatsink For A4988.ipt
mechanics/Electronics/Megatronics/MG128-500 (AWG24-12)_ConnectorBlk_MAIGEN.ipt
mechanics/Electronics/Megatronics/Megatronics V3 Rev h.iam
mechanics/Electronics/Megatronics/Pin header pitch 2.54mm(08 contacts).ipt
mechanics/Electronics/Megatronics/Power Inductors.ipt
mechanics/Electronics/Megatronics/QFN28ET_A4983.ipt
mechanics/Electronics/Megatronics/Quarzo.ipt
mechanics/Electronics/Megatronics/Switch.ipt
mechanics/Electronics/Megatronics/TRIMPOT3MM_TRIMPOTSMD.ipt
mechanics/Electronics/Megatronics/USB.ipt
mechanics/Electronics/Megatronics/User Library-MEM2050.ipt
mechanics/Electronics/Megatronics/User Library-Molex - 2-Pin Header with Lock (0.100in pitch).iam
mechanics/Electronics/Megatronics/User Library-Molex - 2-Pin Header with Lock (0.100in pitch)_Molex - Header Base with Lock (0.100in pitch).ipt
mechanics/Electronics/Megatronics/User Library-Molex - 2-Pin Header with Lock (0.100in pitch)_Molex - Header Pin.ipt
mechanics/Electronics/Megatronics/User Library-Molex - 3-Pin Header with Lock (0.100in pitch)_Molex - 3-Pin Header Base with Lock (0.100in pitch).ipt
mechanics/Electronics/Megatronics/User Library-Molex - 3-Pin Header with Lock (0.100in pitch)_Molex - Header Pin.ipt
mechanics/Electronics/Megatronics/User Library-Molex - 4-Pin Header with Lock (0.100in pitch).iam
mechanics/Electronics/Megatronics/buzzer.ipt
mechanics/Electronics/Megatronics/female_header.ipt
mechanics/Electronics/Megatronics/stepstick+female adapter.iam
mechanics/Electronics/Megatronics/stepstick.ipt
mechanics/Electronics/NHD-0420CW.ipt
mechanics/Electronics/ST4118L1804-A.ipt
mechanics/Electronics/ST4118L1804-B.ipt
mechanics/Hardware/0.375x1.000 Steel Spring (9657K306).ipt
mechanics/Hardware/4x13 SS Ball Bearing (7804K103).ipt
mechanics/Hardware/5mm shaft coupler.ipt
mechanics/Hardware/5x16 SS Ball Bearing (6153K150).ipt
mechanics/Hardware/8x25 Linear Bearing (63255K45).ipt
mechanics/Hardware/M3 SS Nut.ipt
mechanics/Hardware/M3 SS Washer.ipt
mechanics/Hardware/M3x10 SS SHCS.ipt
mechanics/Hardware/M3x12 SS Standoff.ipt
mechanics/Hardware/M3x16 SS SHCS.ipt
mechanics/Hardware/M3x8 SS SHCS.ipt
mechanics/Hardware/M4 SS Locknut.ipt
mechanics/Hardware/M4 SS Nut.ipt
mechanics/Hardware/M4 SS Washer.ipt
mechanics/Hardware/M4x10 SS SHCS.ipt
mechanics/Hardware/M4x12 SS SHCS.ipt
mechanics/Hardware/M4x16 SS SHCS.ipt
mechanics/Hardware/M4x20 SS SHCS.ipt
mechanics/Hardware/M4x25 SS SHCS.ipt
mechanics/Hardware/M4x25 SS Standoff FF (94868A045).ipt
mechanics/Hardware/M4x30 SS SHCS.ipt
mechanics/Hardware/M4x30 SS Standoff FF (94868A183).ipt
mechanics/Hardware/M4x35 SS SHCS.ipt
mechanics/Hardware/M4x40 SS FHSS.ipt
mechanics/Hardware/M4x40 SS SHCS.ipt
mechanics/Hardware/M4x50 SS SHCS.ipt
mechanics/Hardware/M4x6 Alloy SS.ipt
mechanics/Hardware/M5 SS Fender Washer.ipt
mechanics/Hardware/M6 SS Nut.ipt
mechanics/Hardware/M6 SS Washer.ipt
mechanics/Hardware/M8 SS Nut.ipt
mechanics/Hardware/T2.5 16T Pulley.ipt
mechanics/Hopper/Hopper 5mm Axle.ipt
mechanics/Hopper/Hopper Belt.ipt
mechanics/Hopper/Hopper Bottom Brace.ipt
mechanics/Hopper/Hopper Feed Wall.ipt
mechanics/Hopper/Hopper Idler (mirrored).ipt
mechanics/Hopper/Hopper Idler.ipt
mechanics/Hopper/Hopper Leg Brace.ipt
mechanics/Hopper/Hopper Linear Bearing Holder.ipt
mechanics/Hopper/Hopper M6 rod.ipt
mechanics/Hopper/Hopper Motor Holder.ipt
mechanics/Hopper/Hopper Nut Trap Holder.ipt
mechanics/Hopper/Hopper Nut Trap.ipt
mechanics/Hopper/Hopper Outer Wall with Megatronics mount.ipt
mechanics/Hopper/Hopper Outer Wall.ipt
mechanics/Hopper/Hopper Rod Clamp.ipt
mechanics/Hopper/Hopper Side.ipt
mechanics/Hopper/Hopper Smooth Rod Clamp.ipt
mechanics/Hopper/Hopper Smooth Rod.ipt
mechanics/Hopper/Hopper Top.ipt
mechanics/Hopper/Hopper Wall.ipt
mechanics/Piston/Piston Build Frame.ipt
mechanics/Piston/Piston Build Surface.ipt
mechanics/Piston/Piston Driver Clamp.ipt
mechanics/Piston/Piston Feed Frame.ipt
mechanics/Piston/Piston Feed Surface.ipt
mechanics/Piston/Piston Flag Holder.ipt
mechanics/Piston/Piston Flag.ipt
mechanics/Piston/Piston Guide Holder.ipt
mechanics/Piston/Piston Guide Rod 8mm.ipt
mechanics/Piston/Piston Lead Screw M8.ipt
mechanics/Piston/Piston Motor Holder.ipt
mechanics/Piston/Piston Nut Trap.ipt
mechanics/Piston/Piston Wall Guide Small.ipt
mechanics/Piston/Piston Wall Guide Wide.ipt
mechanics/Piston/Piston Wall Guide.ipt
mechanics/STLs/Hopper Nut Trap Holder.stl
mechanics/STLs/Hopper Nut Trap.stl
mechanics/STLs/Piston Nut Trap.stl
mechanics/Spreader/Spreader Belt Clamp.ipt
mechanics/Spreader/Spreader Flag.ipt
mechanics/Spreader/Spreader Frame.ipt
mechanics/Spreader/Spreader Holder.ipt
mechanics/Spreader/Spreader Linear Bearing Clamp.ipt
mechanics/Spreader/Spreader Threaded Rod M4.ipt
mechanics/Spreader/Spreader.ipt
mechanics/Subassemblies/5mm shaft coupler assy.iam
mechanics/Subassemblies/Carriage assy.iam
mechanics/Subassemblies/Controls GUI assy.iam
mechanics/Subassemblies/Hopper Bottom assy.iam
mechanics/Subassemblies/Hopper Driver Holder assy.iam
mechanics/Subassemblies/Hopper Idler assy (mirrored).iam
mechanics/Subassemblies/Hopper Idler assy.iam
mechanics/Subassemblies/Hopper Linear Guide assy.iam
mechanics/Subassemblies/Hopper Linear Guide with endstop assy.iam
mechanics/Subassemblies/Hopper Motor Holder assy.iam
mechanics/Subassemblies/Hopper Nut Trap assy.iam
mechanics/Subassemblies/Hopper Sheet Metal assy.iam
mechanics/Subassemblies/Interface assy.iam
mechanics/Subassemblies/Piston Build Platform assy.iam
mechanics/Subassemblies/Piston Feed Platform assy.iam
mechanics/Subassemblies/Piston Flag assy.iam
mechanics/Subassemblies/Piston Guide assy.iam
mechanics/Subassemblies/Piston Motor Holder assy.iam
mechanics/Subassemblies/Piston Wall Guide Small assy.iam
mechanics/Subassemblies/Piston Wall Guide Wide assy.iam
mechanics/Subassemblies/Piston Wall Guide assy.iam
mechanics/Subassemblies/Spreader assy.iam
mechanics/Subassemblies/X-axis Driver Holder assy.iam
mechanics/Subassemblies/X-axis Idler 1 assy.iam
mechanics/Subassemblies/X-axis Idler 2 assy.iam
mechanics/Subassemblies/X-axis Motor Holder assy.iam
mechanics/Subassemblies/X-axis Y-axis Motor Holder assy.iam
mechanics/Subassemblies/X-axis assy.iam
mechanics/Subassemblies/Y-axis Belt Idler assy.iam
mechanics/Subassemblies/Y-axis Frame Return assy.iam
mechanics/Subassemblies/Y-axis assy.iam
mechanics/Water/Reservoir.ipt
mechanics/X-axis/X-axis Axle 5mm.ipt
mechanics/X-axis/X-axis Driver Holder.ipt
mechanics/X-axis/X-axis Holder Coupler.ipt
mechanics/X-axis/X-axis Idler.ipt
mechanics/X-axis/X-axis Motor Holder.ipt
mechanics/X-axis/X-axis Rod 8mm.ipt
mechanics/X-axis/X-axis Rod Holder.ipt
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
