madog/planb/electronics/boost-demux_v1.1.brd

## EAGLE design electronics/boost-demux_v1.1.brd (2017-10-24)

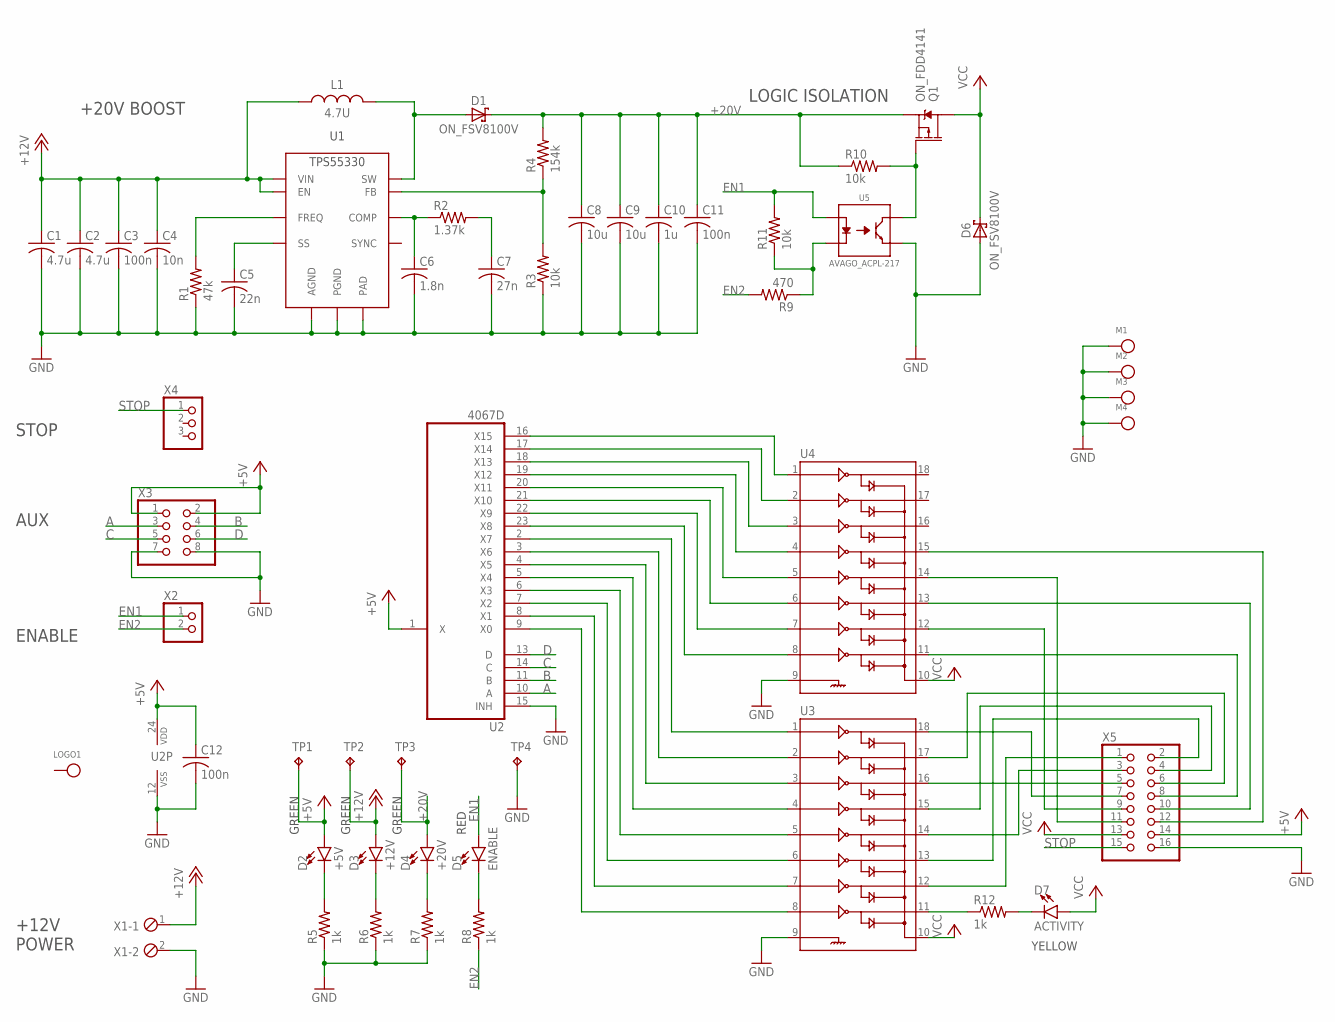
[picture p41: schematic boost-demux_v1.1.sch]

Parts:
C1, C2: 4.7u; C1206
C3, C11, C12: 100n; C1206
C4: 10n; C1206
C5: 22n; C1206
C6: 1.8n; C0805
C7: 27n; C0805
C8, C9: 10u; C1206
C10: 1u; C1206
D1, D6: ON_FSV8100V; TO-277-3
D2: +5V; LED_5MM
D3: +12V; LED_5MM
D4: +20V; LED_5MM
D5: ENABLE; LED_5MM
D7: ACTIVITY; LED_5MM
L1: 4.7U; 4440
LOGO1: MADOG
M1, M2, M3, M4: 6-32_MOUNT
Q1: ON_FDD4141; TO-252-3
R1: 47k; R1206
R2: 1.37k; R0805
R3, R10, R11: 10k; R0805
R4: 154k; R0805
R5, R6, R7, R8, R12: 1k; R1206
R9: 470; R1206
TP1, TP2, TP3, TP4: TPB1,27; B1,27
U1: TI_TPS55330; S-PWQFN-N16
U2: 4067D; SO24W
U3, U4: ULN2803SOICW; SO18L
U5: AVAGO_ACPL-217; SOIC-4
X1: MPT2; 2POL254
X2: PINHD-1X2/90; 1X02/90
X3: PINHD-2X4/90; 2X04/90
X4: PINHD-1X3/90; 1X03/90
X5: PINHD-2X8; 2X08

Connections:
+5V: C12.1, D2.A, TP1.TP, U2.1 (X), U2.24 (VDD), X3.1, X3.2, X5.14
+12V: C1.1, C2.1, C3.1, C4.1, D3.A, L1.1, TP2.TP, U1.2 (VIN), U1.3 (EN), X1.1
+20V: C8.1, C9.1, C10.1, C11.1, D1.P$3 (C), D4.A, Q1.P$3 (S), R4.2, R10.1, TP3.TP
A: U2.10 (A), X3.3
B: U2.11 (B), X3.4
C: U2.14 (C), X3.5
D: U2.13 (D), X3.6
EN1: D5.A, R11.2, U5.P$1, X2.1
EN2: R8.1, R9.2, X2.2
GND: C1.2, C2.2, C3.2, C4.2, C5.2, C6.2, C7.2, C8.2, C9.2, C10.2, C11.2, C12.2, D6.P$1 (A), D6.P$2 (A), M1.P$1, M1.P$2, M1.P$3, M1.P$4, M1.P$5, M1.P$6, M1.P$7, M1.P$8, M1.P$9, M2.P$1, M2.P$2, M2.P$3, M2.P$4, M2.P$5, M2.P$6, M2.P$7, M2.P$8, M2.P$9, M3.P$1, M3.P$2, M3.P$3, M3.P$4, M3.P$5, M3.P$6, M3.P$7, M3.P$8, M3.P$9, M4.P$1, M4.P$2, M4.P$3, M4.P$4, M4.P$5, M4.P$6, M4.P$7, M4.P$8, M4.P$9, R1.1, R3.1, R5.1, R6.1, R7.1, TP4.TP, U1.6 (AGND), U1.11 (PGND), U1.12 (PGND), U1.13 (PGND), U1.PAD, U2.12 (VSS), U2.15 (INH), U3.9, U4.9, U5.P$3, X1.2, X3.7, X3.8, X5.16
unnamed: R1.2, U1.9 (FREQ)
unnamed: C5.1, U1.4 (SS)
unnamed: C6.1, R2.1, U1.7 (COMP)
unnamed: C7.1, R2.2
unnamed: R3.2, R4.1, U1.8 (FB)
unnamed: D2.K (C), R5.2
unnamed: D1.P$1 (A), D1.P$2 (A), L1.2, U1.1 (SW), U1.15 (SW), U1.16 (SW)
unnamed: D3.K (C), R6.2
unnamed: D4.K (C), R7.2
unnamed: D5.K (C), R8.2
unnamed: U2.9 (X0), U3.8
unnamed: R12.1, U3.11
unnamed: Q1.P$1 (G), R10.2, U5.P$4
unnamed: U3.12, X5.1
unnamed: U2.8 (X1), U3.7
unnamed: U2.7 (X2), U3.6
unnamed: U2.6 (X3), U3.5
unnamed: U3.13, X5.2
unnamed: R9.1, R11.1, U5.P$2
unnamed: U2.5 (X4), U3.4
unnamed: U2.4 (X5), U3.3
unnamed: U2.3 (X6), U3.2
unnamed: U2.2 (X7), U3.1
unnamed: U2.23 (X8), U4.8
unnamed: U2.22 (X9), U4.7
unnamed: U2.21 (X10), U4.6
unnamed: U2.20 (X11), U4.5
unnamed: U2.19 (X12), U4.4
unnamed: U2.18 (X13), U4.3
unnamed: U2.17 (X14), U4.2
unnamed: U2.16 (X15), U4.1
unnamed: U3.14, X5.3
unnamed: U3.15, X5.4
unnamed: U3.16, X5.5
unnamed: U3.17, X5.6
unnamed: U3.18, X5.7
unnamed: U4.11, X5.8
unnamed: U4.12, X5.9
unnamed: U4.13, X5.10
unnamed: U4.14, X5.11
unnamed: U4.15, X5.12
unnamed: D7.K (C), R12.2
STOP: X4.1, X5.15
VCC: D6.P$3 (C), D7.A, Q1.P$4 (D), U3.10, U4.10, X5.13

Notes on the sheet:
+12V POWER
AUX
+20V BOOST
LOGIC ISOLATION
ENABLE
STOP
GREEN
RED
YELLOW

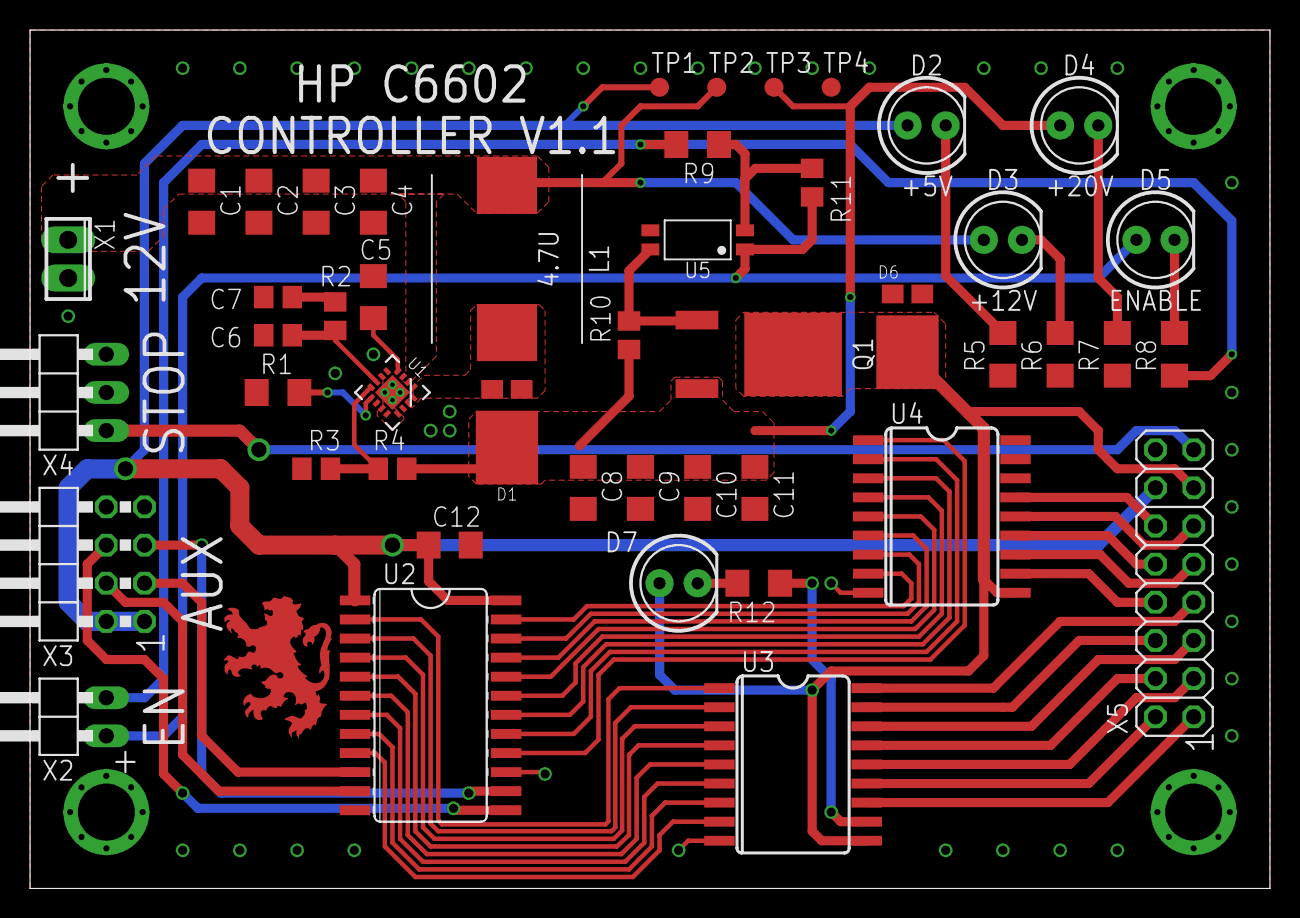
[picture p42: board boost-demux_v1.1.brd from above]

Board: 2 copper layers, 82.5 x 57.1 mm, 52 parts (0 on the bottom side), 54 nets.
