madog/planb/electronics/ffc-breakout_v1.1.brd

## EAGLE design electronics/ffc-breakout_v1.1.brd (2017-10-23)

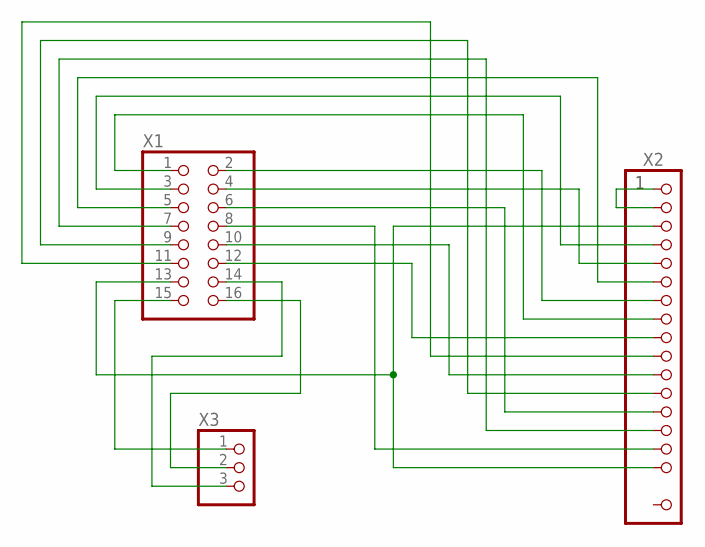
[picture p43: schematic ffc-breakout_v1.1.sch]

Parts:
X1: PINHD-2X8; 2X08
X2: AMP_SFW16R-2STE1LF
X3: PINHD-1X3/90; 1X03/90

Connections:
unnamed: X1.16, X3.2
unnamed: X1.15, X3.1
unnamed: X1.13, X2.P$3 (3), X2.P$16 (16)
unnamed: X1.14, X3.3
unnamed: X2.P$1 (1), X2.P$2 (2)
unnamed: X1.1, X2.P$8 (8)
unnamed: X1.2, X2.P$7 (7)
unnamed: X1.3, X2.P$4 (4)
unnamed: X1.4, X2.P$5 (5)
unnamed: X1.5, X2.P$6 (6)
unnamed: X1.6, X2.P$13 (13)
unnamed: X1.7, X2.P$14 (14)
unnamed: X1.8, X2.P$15 (15)
unnamed: X1.9, X2.P$12 (12)
unnamed: X1.10, X2.P$11 (11)
unnamed: X1.11, X2.P$10 (10)
unnamed: X1.12, X2.P$9 (9)

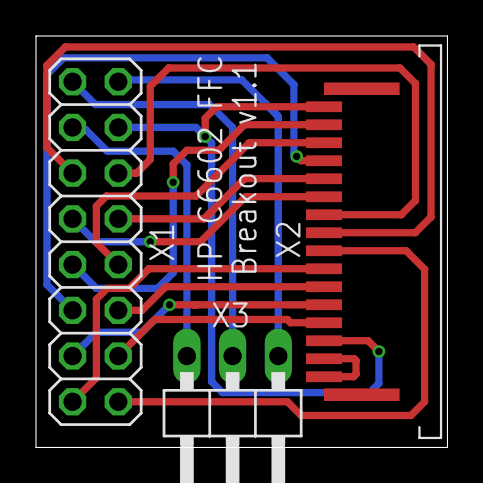
[picture p44: board ffc-breakout_v1.1.brd from above]

Board: 2 copper layers, 22.9 x 22.9 mm, 3 parts (0 on the bottom side), 17 nets.
