madog/planb/electronics/revisions/ffc-breakout_v1.brd

## EAGLE design electronics/revisions/ffc-breakout_v1.brd (2017-09-09)

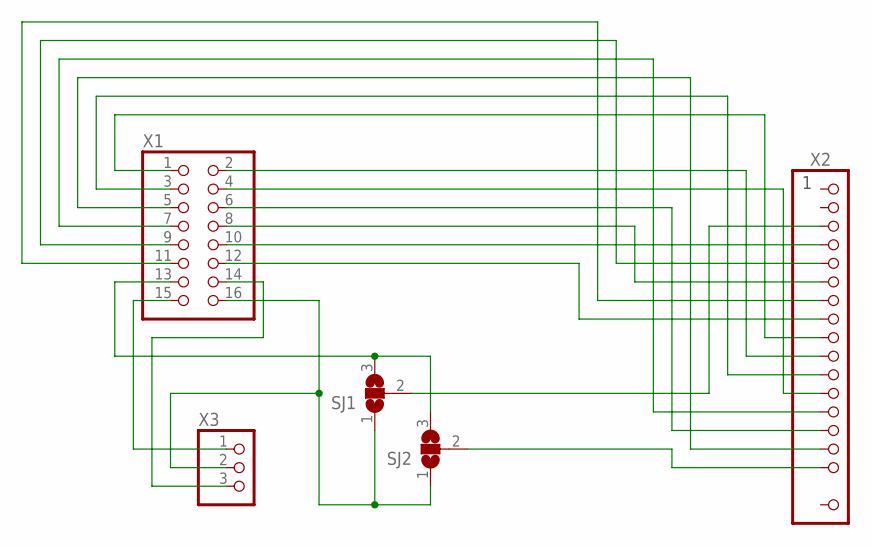
[picture p45: schematic ffc-breakout_v1.sch]

Parts:
SJ1, SJ2: SJ2W; SJ_2
X1: PINHD-2X8; 2X08
X2: AMP_SFW16R-2STE1LF
X3: PINHD-1X3/90; 1X03/90

Connections:
unnamed: SJ1.1, SJ2.1, X1.16, X3.2
unnamed: X1.15, X3.1
unnamed: SJ1.3, SJ2.3, X1.13
unnamed: X1.14, X3.3
unnamed: SJ1.2, X2.P$3 (3)
unnamed: X1.1, X2.P$9 (9)
unnamed: SJ2.2, X2.P$16 (16)
unnamed: X1.2, X2.P$10 (10)
unnamed: X1.3, X2.P$11 (11)
unnamed: X1.4, X2.P$12 (12)
unnamed: X1.5, X2.P$15 (15)
unnamed: X1.6, X2.P$14 (14)
unnamed: X1.7, X2.P$13 (13)
unnamed: X1.8, X2.P$6 (6)
unnamed: X1.9, X2.P$5 (5)
unnamed: X1.10, X2.P$4 (4)
unnamed: X1.11, X2.P$7 (7)
unnamed: X1.12, X2.P$8 (8)

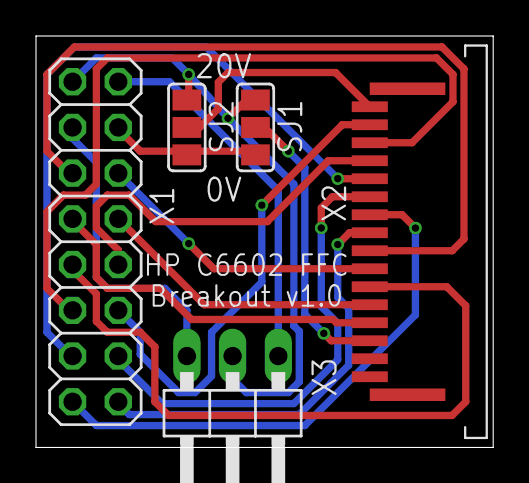
[picture p46: board ffc-breakout_v1.brd from above]

Board: 2 copper layers, 25.4 x 22.9 mm, 5 parts (0 on the bottom side), 18 nets.
