madog/planb/(commit log)

2017-08-27 Eagle project + schematic
    [boost-demux_v1.sch]
2017-09-01 Components library - FFC connector (unfinished)
2017-09-02 Lib updates + boost-demux design
    [2017-09-01_16-00-06.sch, boost-demux_v1.sch]
2017-09-03 Slight update to boost-demux schematic
    [boost-demux_v1.sch]
2017-09-05 PCB draft less markup
    [boost-demux_v1.brd, boost-demux_v1.sch]
2017-09-05 Added minor PCB markup
    [2017-09-01_16-00-06.sch, boost-demux_v1.brd, boost-demux_v1.sch]
2017-09-06 Updates to boost-demux and FFC breakout
    [boost-demux_v1.brd, boost-demux_v1.sch, ffc-breakout_v1.sch]
2017-09-06 FFC breakout autoroute
    [ffc-breakout_v1.brd, ffc-breakout_v1.sch]
2017-09-06 FFC - much better autoroute + cleanup and markup
    [ffc-breakout_v1.brd, ffc-breakout_v1.sch]
2017-09-06 DRC fixes
    [ffc-breakout_v1.brd, ffc-breakout_v1.sch]
2017-09-06 BOM + minor FFC update
    [boost-demux_v1.csv, ffc-breakout_v1.brd, ffc-breakout_v1.sch, master_v1.xlsx]
2017-09-09 BOM updates and minor DRC fixes
    [boost-demux_v1.brd, boost-demux_v1.csv, boost-demux_v1.sch, ffc-breakout_v1.brd, master_v1.xlsx]
2017-09-11 Rearrange + add mechanics and software files
    [4x20 LCD.SLDPRT, 4x20 LCD.ipt, 5mm X-axis axel.SLDPRT, 5mm X-axis axel.ipt, C6602A.SLDPRT, C6602A.ipt, Carriage assembly.SLDASM, Carriage assembly.iam]
2017-09-14 Removed Inventor files temporarily
    [4x20 LCD.ipt, 5mm X-axis axel.ipt, C6602A.ipt, Carriage assembly.iam, Cartridge carrier.ipt, Cil screw M3 x 10.ipt, Cil screw M3 x 16.ipt, Cil screw M4 x 16.ipt]
2017-09-14 Updated all SW files to latest format
    [4x20 LCD.SLDPRT, 5mm X-axis axel.SLDPRT, C6602A.SLDPRT, Carriage assembly.SLDASM, Cartridge carrier.SLDPRT, Cil screw M3 x 10.SLDPRT, Cil screw M3 x 16.SLDPRT, Cil screw M4 x 16.SLDPRT]
2017-09-14 Beginning of Inventor feature recognition
    [4x20 LCD.ipt, X-axis axle.ipt]
2017-09-14 Additional Inventor parts
    [C6602A.ipt, Carriage Belt Clamp.ipt]
2017-09-14 More parts + hardware
    [Carriage Carrier.ipt, Carriage Cartridge Adapter.ipt, Cartridge Carrier.ipt, M3 SS Nut.ipt, M3x10 SS SHCS.ipt, M3x12 SS Standoff.ipt, M3x16 SS SHCS.ipt, M4 SS Locknut.ipt]
2017-09-14 More hardware
    [0.375x1.000 Steel Spring (9657K306).ipt, 4x13 SS Ball Bearing (7804K103).ipt, 5x16 SS Ball Bearing (6153K150).ipt, 8x25 Linear Bearing (61205K750).ipt, M3 SS Washer.ipt, M4 SS Washer.ipt, M4x40 SS FHSS.ipt, M6 SS Washer.ipt]
2017-09-15 Started sheet metal models
    [Cartridge Carrier.ipt, Driver Clamp.ipt, GUI Button.ipt, GUI Corner Holder.ipt, GUI Face.ipt, Hopper 5mm Axle.ipt, Hopper Bottom Brace.ipt, Hopper Wall with Megatronics mount.ipt]
2017-09-15 Lots of parts
    [Hopper Feed Wall.ipt, Hopper Idler (mirrored).ipt, Hopper Idler.ipt, Hopper Leg Brace.ipt, Hopper Linear Bearing Holder.ipt, Hopper M6 rod.ipt, Hopper Motor Holder.ipt, Hopper Nut Trap Holder.ipt]
2017-09-15 Further parts
    [Hopper Top.ipt, Keypad.ipt]
2017-09-17 Megatronics models
    [0402CAP_CAP0402CAP.ipt, 0402RES_RESISTOR0402RES.ipt, 0805_RESISTOR.ipt, 1206_CAP1206.ipt, 1x1- 2,54 Pitch.iam, 2x1- 2,54 Pitch.iam, 3M 9612xx-5604-AR Body.ipt, 3M 9612xx-5604-AR Pin1.ipt]
2017-09-17 Piston parts
    [Piston Build Frame.ipt, Piston Build Surface.ipt, Piston Driver Clamp.ipt, Piston Feed Frame.ipt, Piston Feed Surface.ipt, Piston Flag Holder.ipt]
2017-09-17 More piston parts
    [Piston Flag.ipt, Piston Guide Holder.ipt, Piston Guide Rod 8mm.ipt, Piston Lead Screw M8.ipt, Piston Motor Holder.ipt, Piston Nut Trap.ipt, Piston Wall Guide Micro Wide.ipt]
2017-09-18 Spreader parts +
    [Piston Lead Screw M8.ipt, Piston Wall Guide Micro.ipt, Piston Wall Guide.ipt, Spreader Belt Clamp.ipt, Spreader Flag.ipt, Spreader Frame.ipt, Spreader Holder.ipt, Spreader Linear Bearing Clamp.ipt]
2017-09-19 X-axis + Y-axis parts
    [X-axis Axle 5mm.ipt, X-axis Driver Clamp.ipt, X-axis Driver Holder.ipt, X-axis Holder Coupler.ipt, X-axis Idler.ipt, X-axis Motor Holder.ipt, X-axis Rod 8mm.ipt, X-axis Rod Holder.ipt]
2017-09-20 More subassembly
    [Hopper Driver Holder.iam]
2017-09-25 Sheet metal mods
    [Piston Build Surface.ipt, Piston Feed Surface.ipt, Piston Flag.ipt, Spreader Flag.ipt, Y-axis Carriage Flag.ipt, Y-axis X-axis Flag.ipt]
2017-09-25 Sheet metal drawings
    [Hopper Top.ipt, Sheet metal.idw]
2017-09-27 Hopper assy's
    [Hopper Linear Guide assy.iam, Hopper Linear Guide with endstop assy.iam, Hopper Motor Holder assy.iam, Hopper Nut Trap assy.iam, Sheet metal.idw]
2017-09-27 More subassemblies + piston guide remodels
    [M4x25 SS SHCS.ipt, Piston Flag assy.iam, Piston Guide Holder assy.iam, Piston Motor Holder assy.iam, Piston Wall Guide Micro Wide.ipt, Piston Wall Guide Micro.ipt, Piston Wall Guide Small assy.iam, Piston Wall Guide Small.ipt]
2017-09-28 Piston assy
    [M4x10 SS SHCS.ipt, M4x12 SS SHCS.ipt, M4x30 SS Standoff FF (94868A183).ipt, Piston Build Frame.ipt, Piston Build Platform assy.0002.iam, Piston Build Platform assy.iam, Piston Guide assy.iam]
2017-09-29 Finished subassys?
    [M4x25 SS Standoff FF (94868A045).ipt, Piston Build Frame.ipt, Piston Build Platform assy.0002.iam, Piston Build Platform assy.iam]
2017-10-03 Sheet metal updates + more assemblies
    [Hopper Sheet Metal assy.iam, M4x35 SS SHCS.ipt, Piston Flag.ipt, Sheet metal.idw, Spreader Flag.ipt, Spreader assy.iam, X-axis Driver Holder assy.iam, X-axis Idler assy.iam]
2017-10-03 Final subassemblies?
    [Y-axis Belt Idler assy.iam, Y-axis Frame Return assy.iam]
2017-10-05 Added STLs for 3D prints, moved Arduino source
    [Carriage Belt Clamp.stl, Carriage Carrier.stl, Carriage Cartridge Adapter.stl, GUI Button.stl, GUI Corner Holder.stl, GUI Face.stl, GUI Rotary.stl, Hopper Idler (mirrored).ipt]
2017-10-07 McMaster parts
    [Hopper M6 rod.ipt, McMaster Parts.xlsx]
2017-10-11 Parts list
    [Hopper Sheet Metal assy.iam, McMaster Parts.xlsx, Parts List.xlsx]
2017-10-13 Fixed test program bugs
    [C6602_test.ino]
2017-10-16 Pump test program update
2017-10-17 Draft PCB updates
    [boost-demux_v1.1.brd, boost-demux_v1.1.sch, boost-demux_v1.brd, boost-demux_v1.sch, ffc-breakout_v1.1.brd, ffc-breakout_v1.1.sch, ffc-breakout_v1.brd, ffc-breakout_v1.sch]
2017-10-19 Minor PCB and parts list update
    [Parts List.xlsx, boost-demux_v1.1.sch]
2017-10-23 Electronics v1.1 draft updates
    [boost-demux_v1.1.brd, boost-demux_v1.1.sch, ffc-breakout_v1.1.brd, ffc-breakout_v1.1.sch]
2017-10-24 PCBs v1.1 final
    [Reservoir.ipt, boost-demux_v1.1.brd, boost-demux_v1.1.sch]
2017-10-27 Main assy
    [X-axis Idler 1 assy.iam, X-axis Idler 2 assy.iam, X-axis assy.iam, Y-axis assy.iam]
2017-11-11 Stepper screw update
    [M3x8 SS SHCS.ipt, Parts List.xlsx, Piston Build Platform assy.iam, Piston Motor Holder assy.iam]
2017-11-14 Main assy updates
    [Hopper Bottom assy.iam]
2017-11-14 Sheet metal assy - screws
    [Hopper Bottom assy.iam, Hopper Linear Guide with endstop assy.iam, Hopper Sheet Metal assy.iam, M3 SS Nut.ipt, M3 SS Washer.ipt, M3x16 SS SHCS.ipt, Piston Flag assy.iam]
2017-11-17 Material/appearance updates
    [Carriage Belt Clamp.ipt, Carriage Carrier.ipt, Carriage Cartridge Adapter.ipt, GUI Button.ipt, GUI Corner Holder.ipt, GUI Face.ipt, GUI Rotary.ipt, Hopper Idler (mirrored).ipt]
2017-11-18 Main assy - spreader updates
    [Hopper Driver Holder assy.iam, Hopper Idler assy (mirrored).iam, Hopper Idler assy.iam, Hopper Motor Holder assy.iam, Hopper Sheet Metal assy.iam, Spreader assy.iam]
2017-11-21 Belts and shaft couplers
    [5mm shaft coupler assy.iam, 5mm shaft coupler.ipt, M4x6 Alloy SS.ipt, Megatronics V3 Rev h.iam, T2.5 16T Pulley.ipt, X-axis Motor Holder assy.iam, X-axis Y-axis Motor Holder assy.iam, X-axis assy.iam]
2017-11-21 Spreader belt
    [Hopper Belt.ipt]
2017-11-21 Removed Solidworks files, moved Inventor model to main directory
    [0.375x1.000 Steel Spring (9657K306).ipt, 0402CAP_CAP0402CAP.ipt, 0402RES_RESISTOR0402RES.ipt, 0805_RESISTOR.ipt, 1206_CAP1206.ipt, 1x1- 2,54 Pitch.iam, 2x1- 2,54 Pitch.iam, 3M 9612xx-5604-AR Body.ipt]
2017-11-25 Minor part updates
    [Hopper Driver Holder assy.iam, Parts List.xlsx, Spreader Holder.ipt, Spreader Holder.stl, Spreader assy.iam, X-axis Idler 2 assy.iam, X-axis Y-axis Motor Holder assy.iam, X-axis assy.iam]
2017-12-08 Minor assembly updates
    [Controls GUI assy.iam, Hopper Motor Holder assy.iam, Spreader Holder.ipt, Spreader Holder.stl, Spreader assy.iam, X-axis assy.iam, Y-axis Belt Idler assy.iam, Y-axis Belt Idler.stl]
2017-12-31 Fix purge volume + add reset
    [C6602_purge.ino]
2018-04-14 Added feed piston heat Started new UI design
    [Interface Frame.ipt, Interface assy.iam, NHD-0420CW.ipt, NHD-0420CW.stp, Omron PEC12R-4x20F-Xxxxx.stp]
